pepelepoisson/geairaredit/README.md

***
This repo contains files about a project called GeaiRareDit. It is all about building a small hand-held game starting with classical SimonSays game. This is very much WIP and shall be updated as project evolves.
***
***
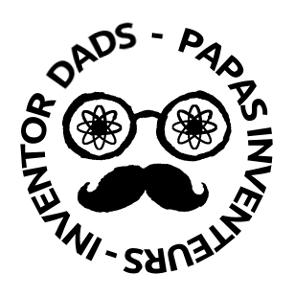
[picture p1: Logo_Papas_Inventeurs_25mm.png]
Inventor Dads logo
