pepelepoisson/geairaredit/CAD/V2 - laser cutting only/Decoupe_condensateur.png

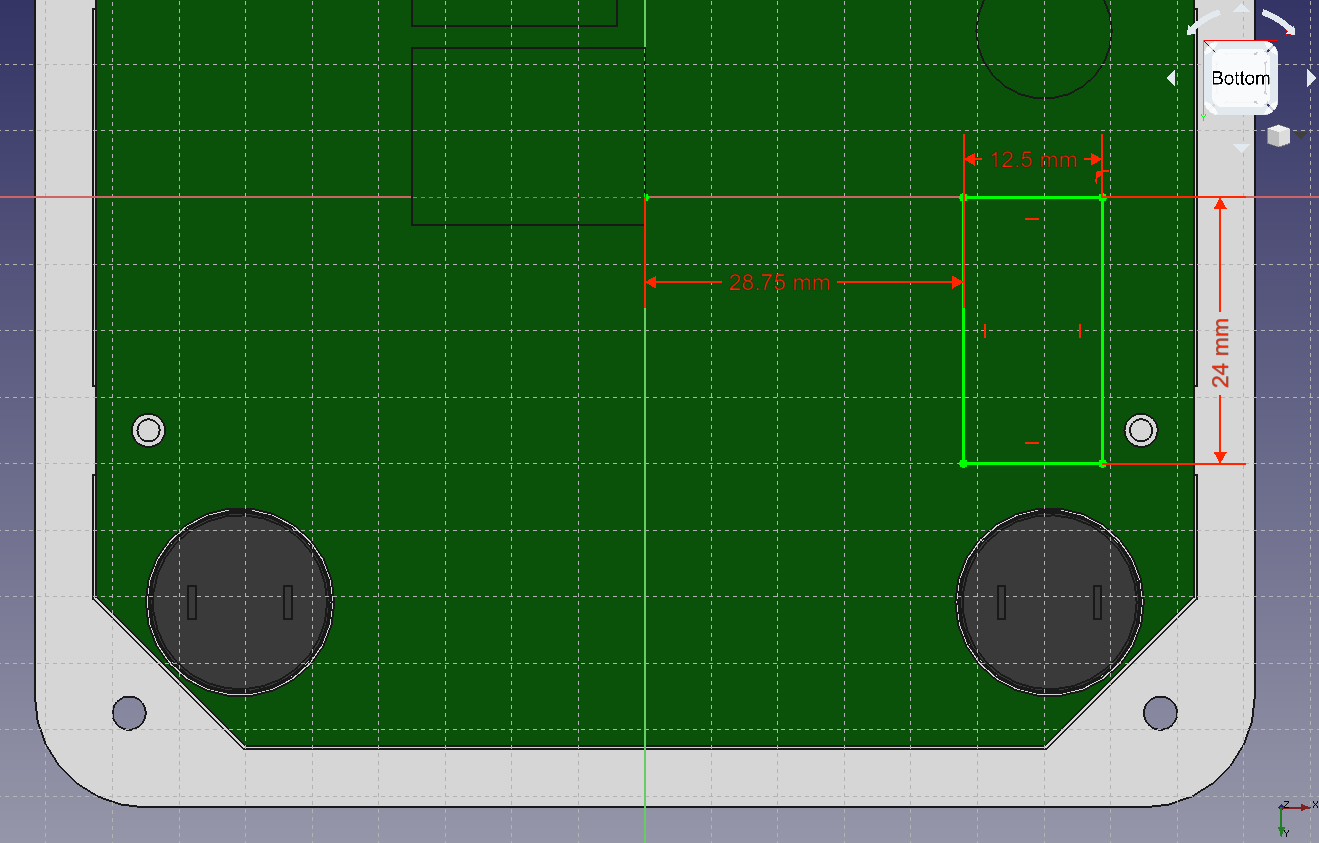
CAD/V2 - laser cutting only/Decoupe_condensateur.png
