pepelepoisson/geairaredit/CAD/V2 - laser cutting only/Dimensions_PCB.png

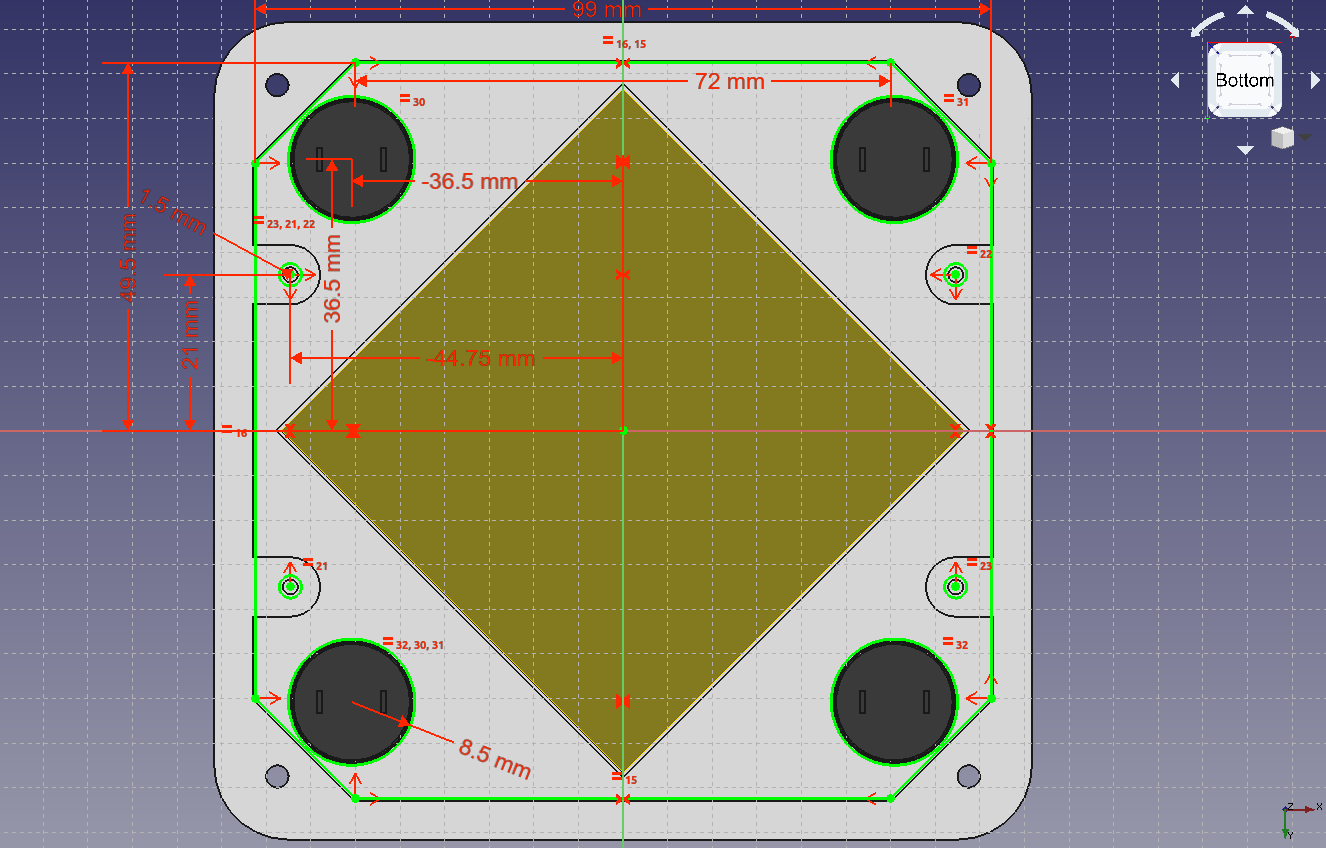
CAD/V2 - laser cutting only/Dimensions_PCB.png
