pepelepoisson/geairaredit/CAD/V2 - laser cutting only/PCB_placement.png

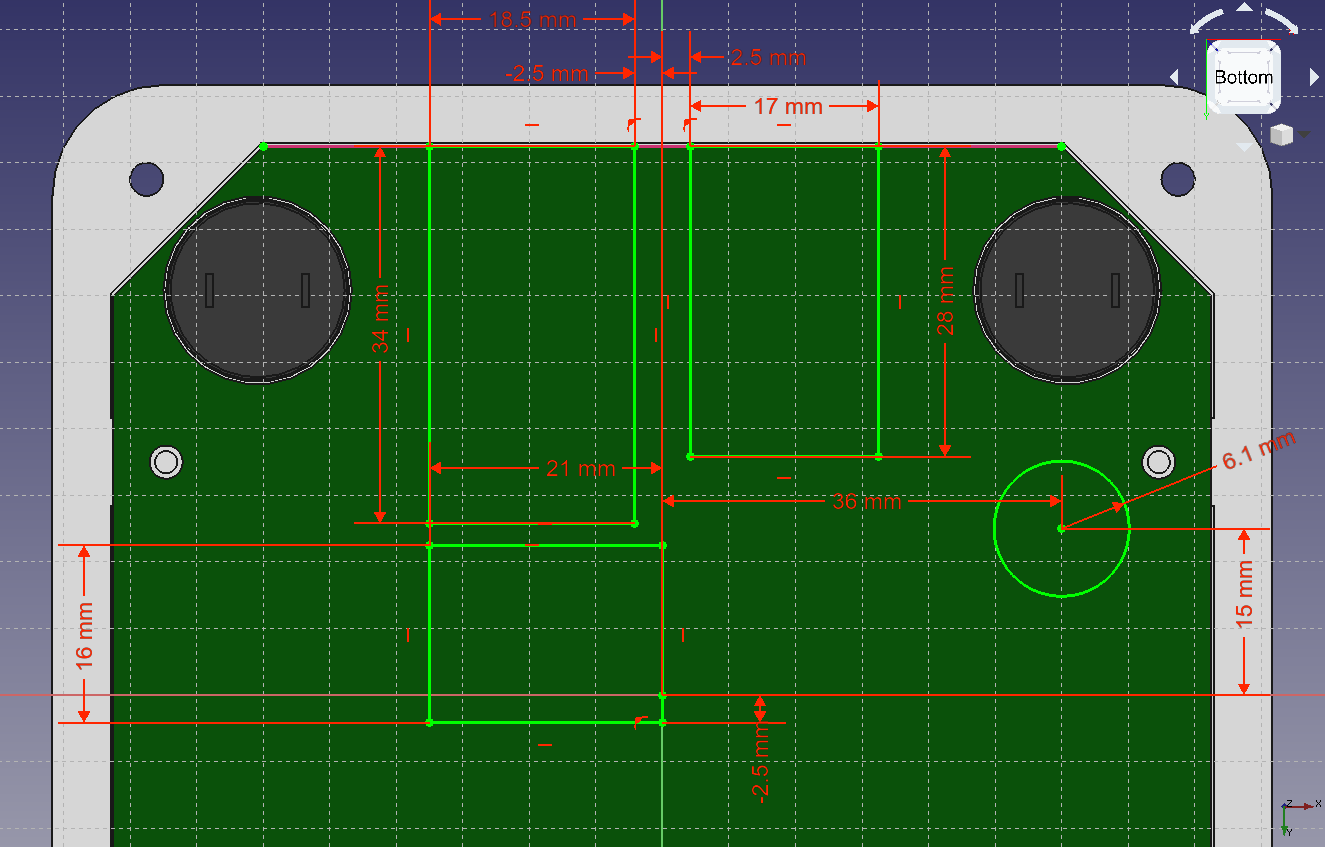
CAD/V2 - laser cutting only/PCB_placement.png
