pepelepoisson/geairaredit/CAD/V2 - laser cutting only/Rendu_arriere.png

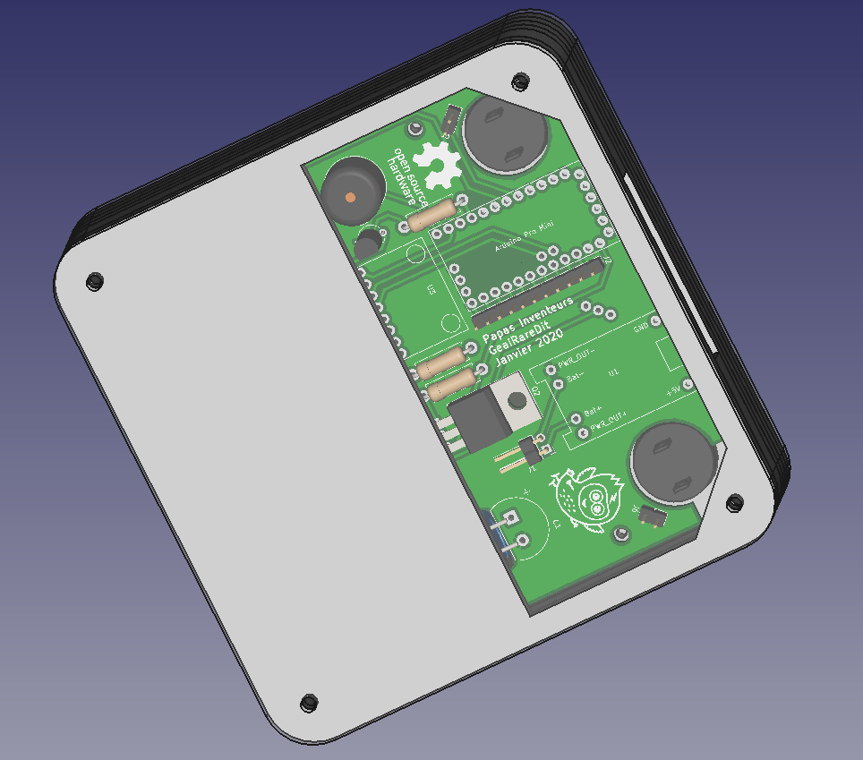
CAD/V2 - laser cutting only/Rendu_arriere.png
