pepelepoisson/geairaredit/CAD/V2 - laser cutting only/Rendu_avant.png

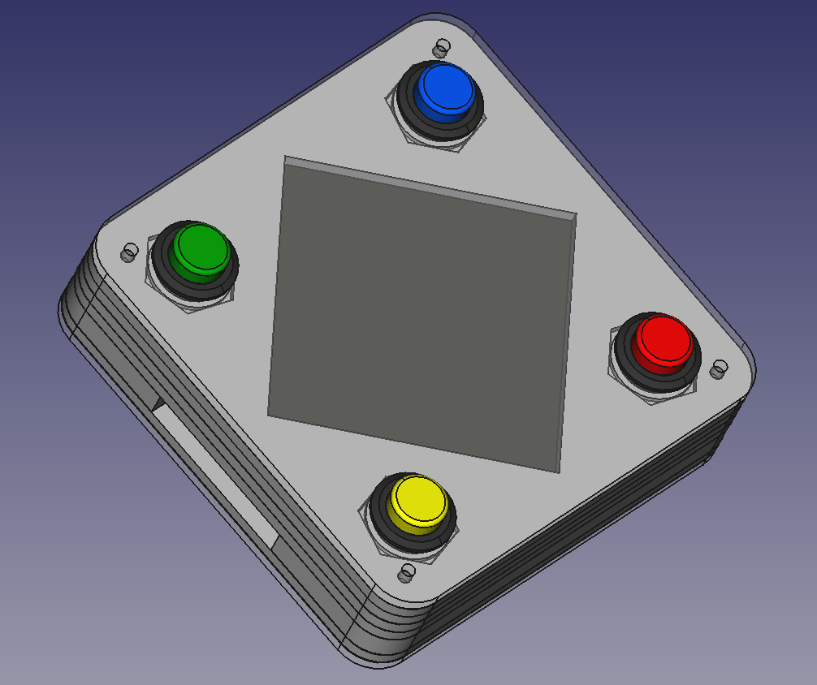
CAD/V2 - laser cutting only/Rendu_avant.png
