pepelepoisson/geairaredit/Power/Tension_decharge.png

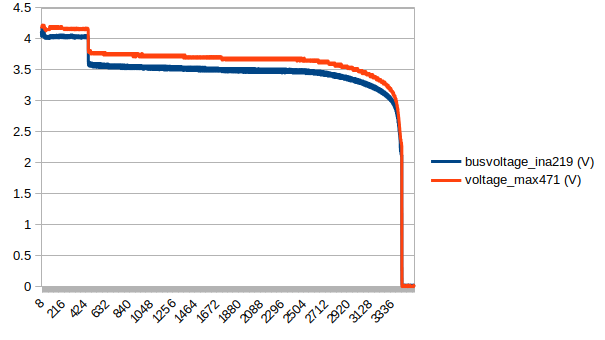
Power/Tension_decharge.png
