pepelepoisson/geairaredit/Rendu_PCB_bleu.png

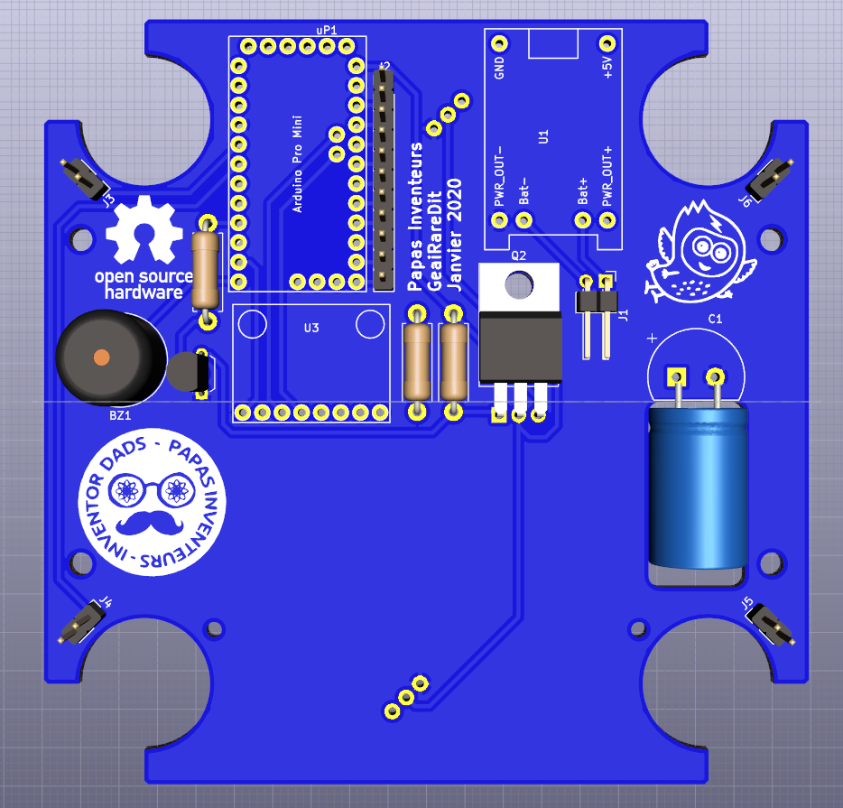
Rendu_PCB_bleu.png
