pepelepoisson/geairaredit/CAD/V1 - laser cutting and 3d printing/3D printing - back/Dessous_prototype_V3.FCStd

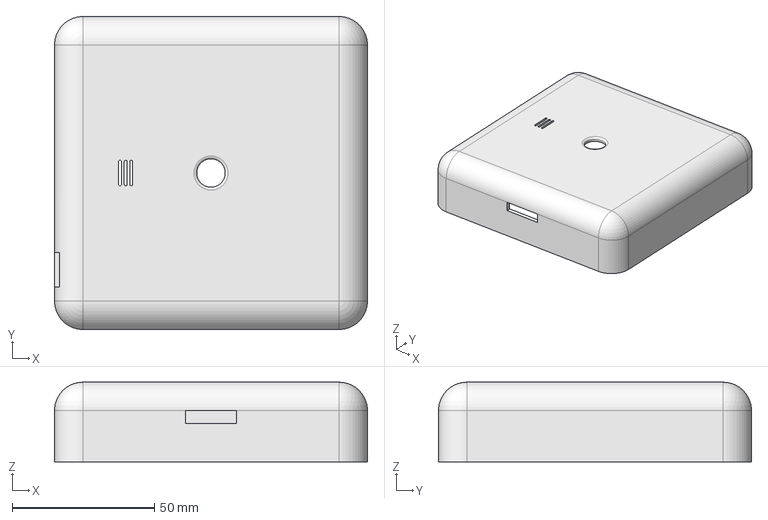
[picture p9: CAD file, 2019-12-19]
CAD/V1 - laser cutting and 3d printing/3D printing - back/Dessous_prototype_V3.FCStd
110.0 x 110.0 x 28.0 mm
