pepelepoisson/geairaredit/CAD/V1 - laser cutting and 3d printing/Laser cutting - front/Face_avant_CTP_proto_1.dxf

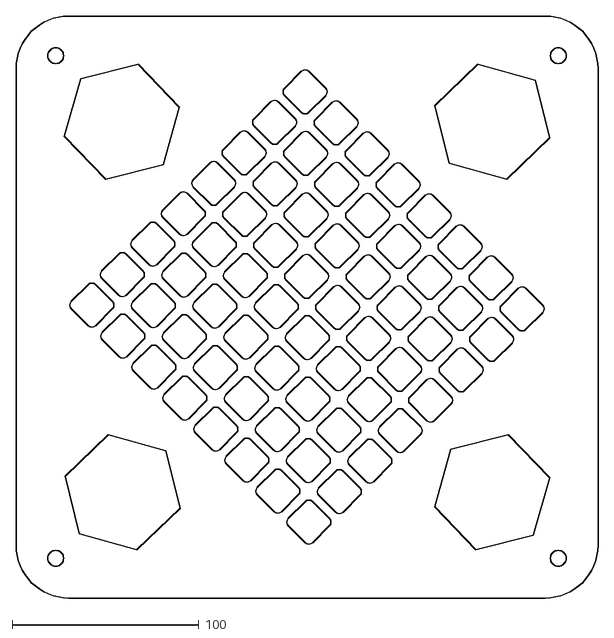
[picture p10: CAD file, 2020-12-04]
CAD/V1 - laser cutting and 3d printing/Laser cutting - front/Face_avant_CTP_proto_1.dxf
311.8 x 311.8
