pepelepoisson/geairaredit/CAD/V2 - laser cutting only/GeaiRareDit_CAD_V4.FCStd

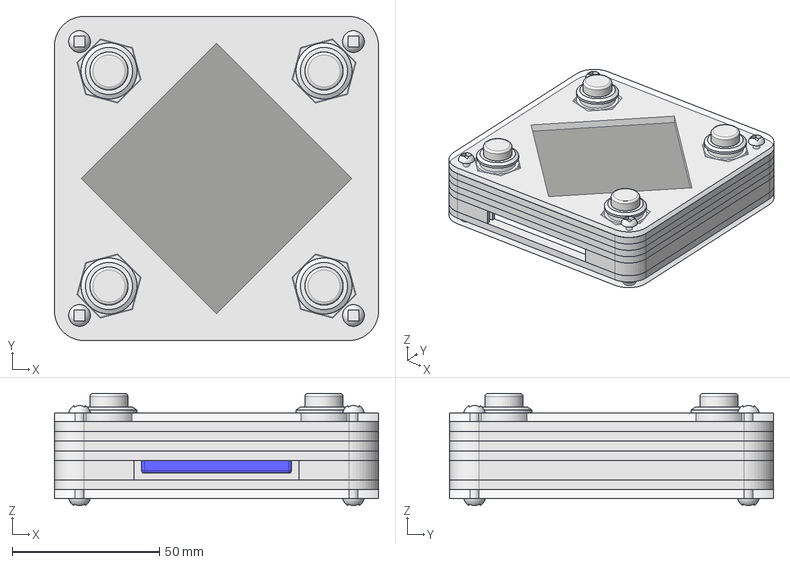
[picture p11: CAD file, 2020-01-23]
CAD/V2 - laser cutting only/GeaiRareDit_CAD_V4.FCStd
110.0 x 110.0 x 38.1 mm
Face_avant_plexi
Face_2_CTP
Matrice_LEDs
Face_3_CTP_maintien_Matrice_LEDs
Face_4_CTP_support_PCB
Face_arriere_plexi
Face_5_CTP_cote_PCB
Interrupteur vert
Interrupteur jaune
Interrupteur rouge
Batterie
Face_7_CTP
Interrupteur bleu
Face_6_CTP_cote_Acces_fils
Vis_1
Vis_2
Vis_3
Vis_4
Vis_8
Vis_7
Vis_6
Vis_5
