pepelepoisson/geairaredit/CAD/V3 - 3d printing only/Back/GeaiRareDitProto2.FCStd

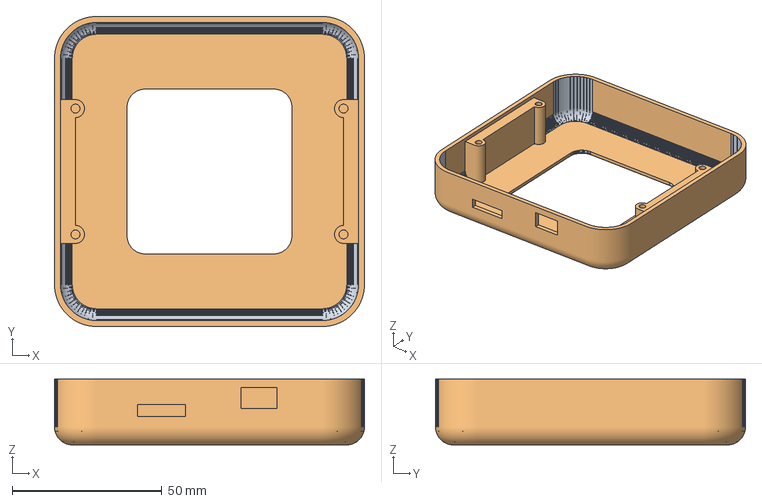
[picture p12: CAD file, 2020-12-04]
CAD/V3 - 3d printing only/Back/GeaiRareDitProto2.FCStd
103.5 x 103.5 x 22.0 mm
Body (Meshed)
