pepelepoisson/geairaredit/CAD/V3 - 3d printing only/Switch_adapter_ring/Bague_montage_boutons.FCStd

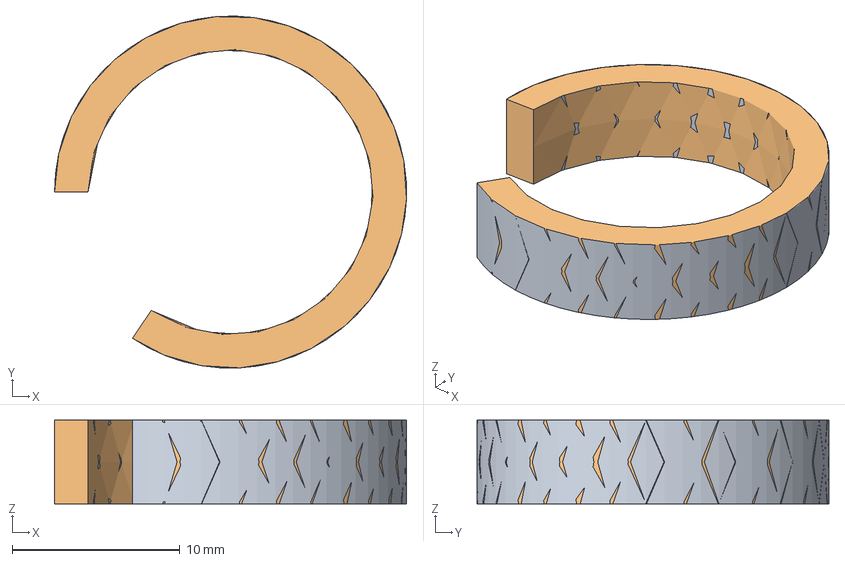
[picture p13: CAD file, 2020-12-04]
CAD/V3 - 3d printing only/Switch_adapter_ring/Bague_montage_boutons.FCStd
21.0 x 21.0 x 5.00 mm
Body (Meshed)
