pepelepoisson/geairaredit/CAD/V4 - CNC and 3d printing/GeaiRareDit_CAD_V6.FCStd

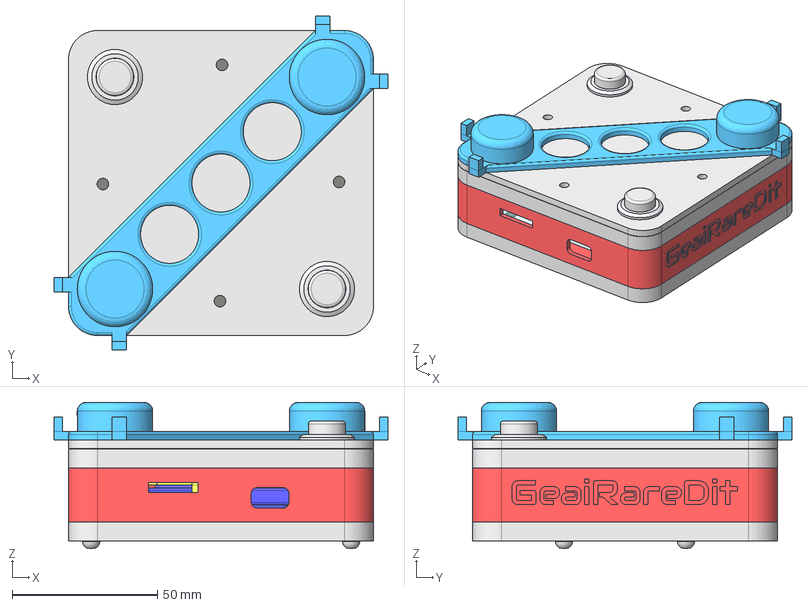
[picture p14: CAD file, 2020-12-16]
CAD/V4 - CNC and 3d printing/GeaiRareDit_CAD_V6.FCStd
115.0 x 115.0 x 50.3 mm
Face_1_CTP_3.3mm
Face_2_CTP_6.6mm
Fond_CTP
Rondelle_4_support_PCB
Rondelle_3_support_PCB
Rondelle_2_support_PCB
Rondelle_1_support_PCB
Vis_001
Vis_002
Vis_003
Vis_004
Batterie_1
Interrupteur bleu
Interrupteur rouge
Interrupteur jaune
Interrupteur vert
Matrice_LEDs
Batterie_002
Fenetre_acrylique
Contour_PLA_logo
Support_batterie_2_dessous
Support_batterie_2_dessus
Protecteur_transport
