pepelepoisson/geairaredit/CAD/V4 - CNC and 3d printing/STL files/Protecteur_transport_V1.stl

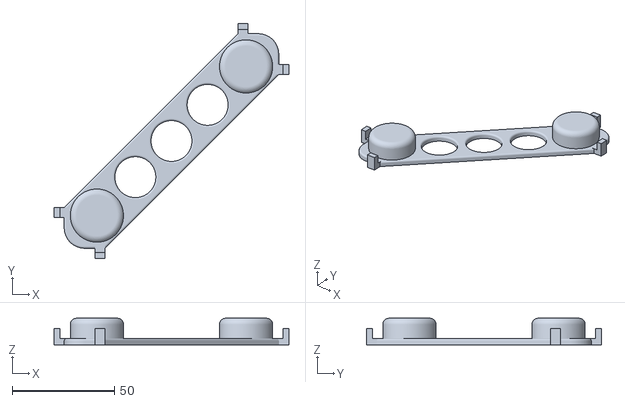
[picture p15: CAD file, 2020-12-16]
CAD/V4 - CNC and 3d printing/STL files/Protecteur_transport_V1.stl
115.0 x 115.0 x 13.0
