pepelepoisson/geairaredit/CAD/V3 - 3d printing only/Back/Boitier_Proto_GeaiRareDit_V3.stl

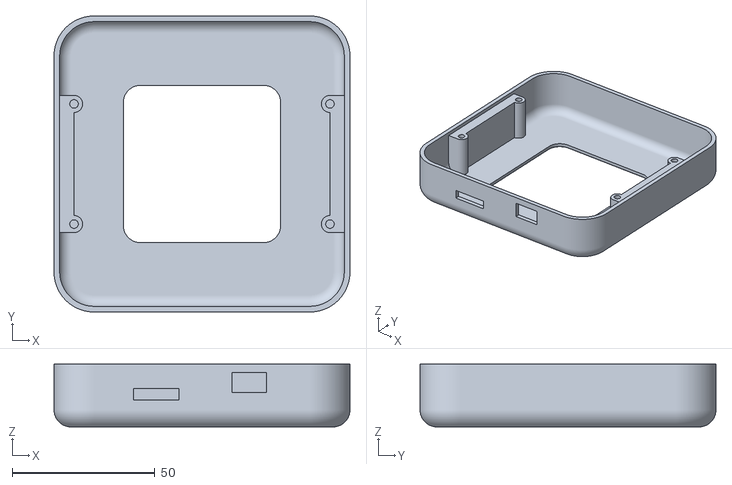
[picture p16: CAD file, 2020-12-04]
CAD/V3 - 3d printing only/Back/Boitier_Proto_GeaiRareDit_V3.stl
103.5 x 103.5 x 22.0
