pepelepoisson/geairaredit/CAD/V4 - CNC and 3d printing/STL files/Porte_batterie_dessous_V2.stl

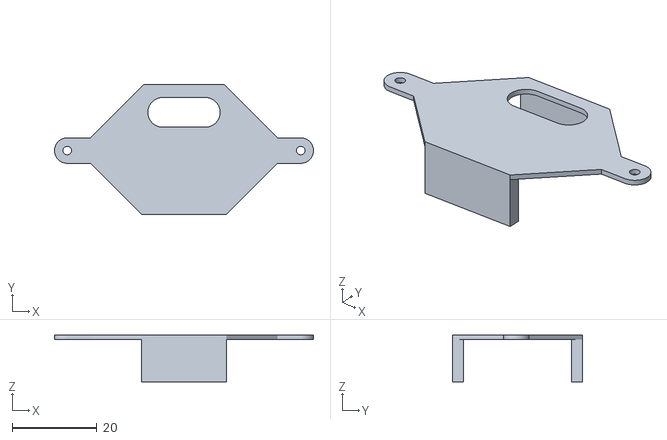
[picture p17: CAD file, 2020-12-10]
CAD/V4 - CNC and 3d printing/STL files/Porte_batterie_dessous_V2.stl
61.0 x 30.5 x 11.0
