pepelepoisson/geairaredit/CAD/V4 - CNC and 3d printing/STL files/Rondelle_support_PCB_V3.stl

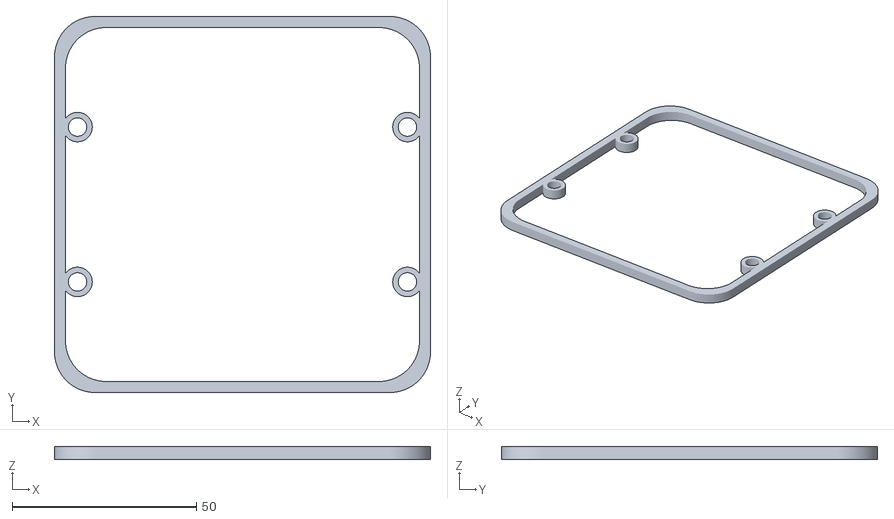
[picture p19: CAD file, 2020-12-10]
CAD/V4 - CNC and 3d printing/STL files/Rondelle_support_PCB_V3.stl
102.0 x 102.0 x 3.50
