pepelepoisson/geairaredit/CAD/V4 - CNC and 3d printing/STL files/Contour_PLA_V3.stl

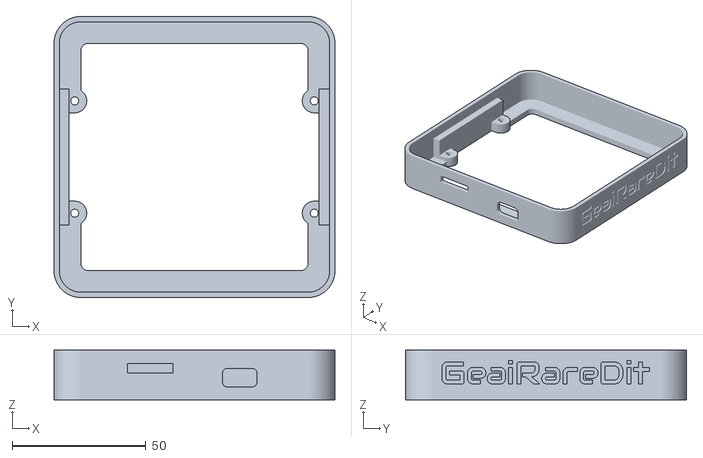
[picture p20: CAD file, 2020-12-10]
CAD/V4 - CNC and 3d printing/STL files/Contour_PLA_V3.stl
105.0 x 105.0 x 18.5
