pepelepoisson/geairaredit/CAD/V1 - laser cutting and 3d printing/3D printing - back/Old/Dessous_prototype_V2.FCStd

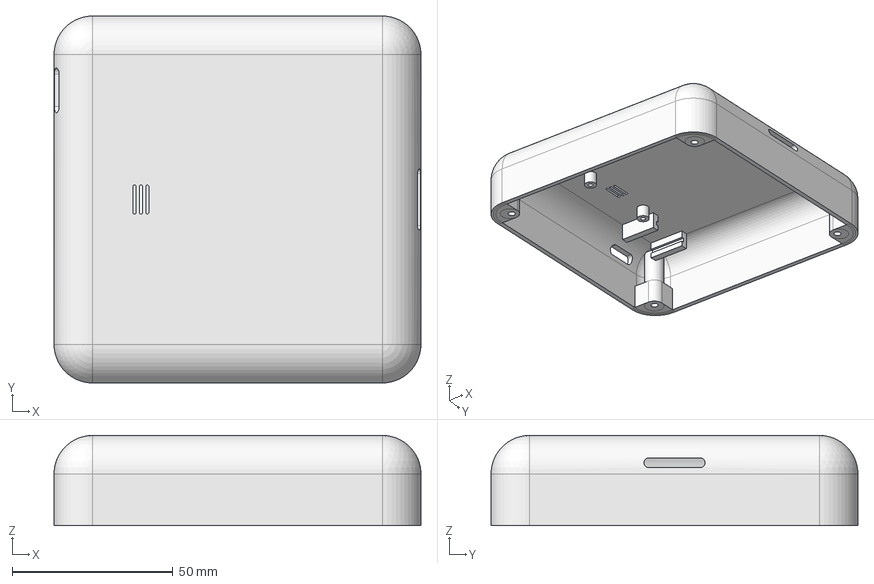
[picture p21: CAD file, 2020-12-04, an earlier design]
CAD/V1 - laser cutting and 3d printing/3D printing - back/Old/Dessous_prototype_V2.FCStd
114.0 x 114.0 x 28.0 mm
