pepelepoisson/geairaredit/CAD/V2 - laser cutting only/Old/GeaiRareDit_CAD_V3.FCStd

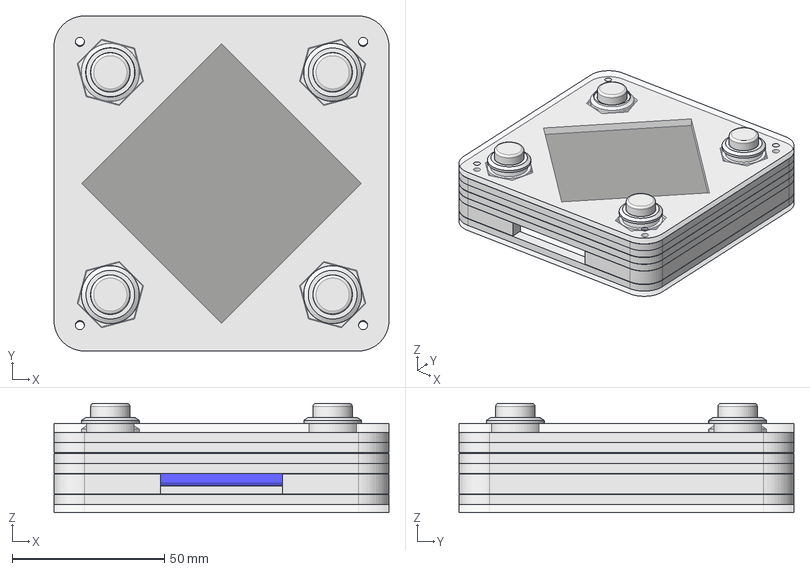
[picture p22: CAD file, 2020-12-04, an earlier design]
CAD/V2 - laser cutting only/Old/GeaiRareDit_CAD_V3.FCStd
110.0 x 110.0 x 35.9 mm
Face_avant_plexi
Face_2_CTP
Matrice_LEDs
PCB
Face_3_CTP
Face_6_CTP
Face_4_CTP
Face_arriere_plexi
Face_5_CTP
Interrupteur bleu
Interrupteur vert
Interrupteur jaune
Interrupteur rouge
Batterie
Face_7_CTP
