pepelepoisson/geairaredit/CAD/V4 - CNC and 3d printing/Old/Exploded_view.fcstd

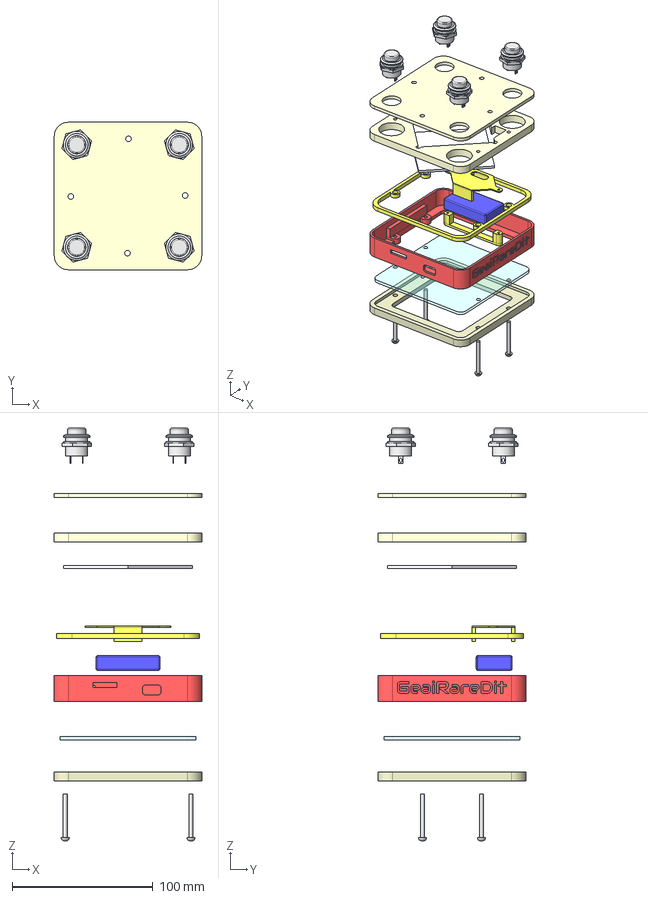
[picture p23: CAD file, 2020-12-16, an earlier design]
CAD/V4 - CNC and 3d printing/Old/Exploded_view.fcstd
105.0 x 105.0 x 293.9 mm
Face_1_CTP_3.3mm
Face_2_CTP_6.6mm
Fond_CTP
Rondelle_1_support_PCB
Vis_001
Vis_002
Vis_003
Vis_004
Interrupteur bleu
Interrupteur rouge
Interrupteur jaune
Interrupteur vert
Matrice_LEDs
Batterie_002
Fenetre_acrylique
Contour_PLA_logo
Support_batterie_2_dessous
Support_batterie_2_dessus
