pepelepoisson/geairaredit/CAD/V2 - laser cutting only/Old/GeaiRareDit_CAD_V2_bkp1.FCStd

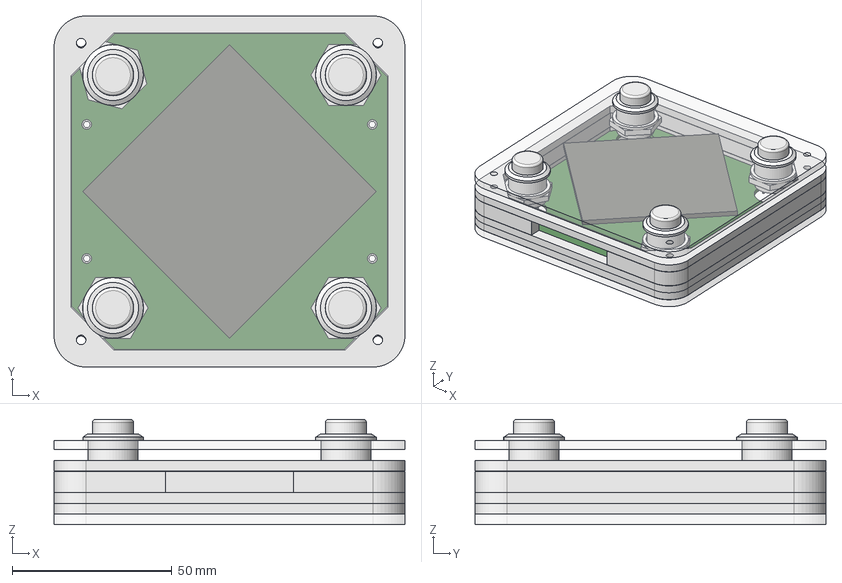
[picture p24: CAD file, 2020-12-04, an earlier design]
CAD/V2 - laser cutting only/Old/GeaiRareDit_CAD_V2_bkp1.FCStd
110.0 x 110.0 x 33.0 mm
Face_avant_plexi
Interrupteur bleu
Matrice_LEDs
PCB
Face_3_CTP
Face_4_CTP
Face_6_CTP
Face_arriere_plexi
Face_5_CTP
Interrupteur rouge
Interrupteur jaune
Interrupteur vert
