pepelepoisson/geairaredit/CAD/V4 - CNC and 3d printing/GeaiRareDit_CAD_V5.FCStd

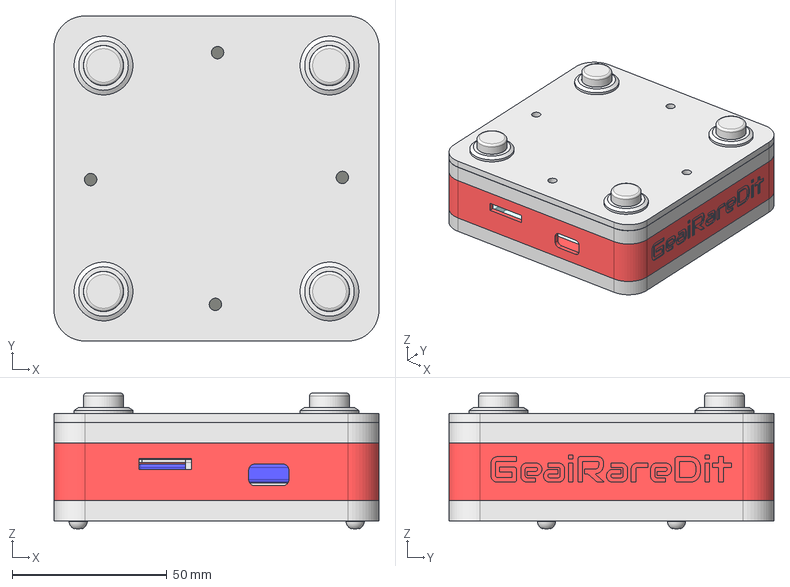
[picture p25: CAD file, 2020-12-10, an earlier design]
CAD/V4 - CNC and 3d printing/GeaiRareDit_CAD_V5.FCStd
105.0 x 105.0 x 43.9 mm
Face_1_CTP_3.3mm
Face_2_CTP_6.6mm
Support_batterie_dessous
Support_batterie_dessus
Fond_CTP
Rondelle_4_support_PCB
Rondelle_3_support_PCB
Rondelle_2_support_PCB
Rondelle_1_support_PCB
Vis_001
Vis_002
Vis_003
Vis_004
Batterie
Interrupteur bleu
Interrupteur rouge
Interrupteur jaune
Interrupteur vert
Matrice_LEDs
Fenetre_acrylique
Contour_PLA_logo
