pepelepoisson/geairaredit/(list of files, cad)

Other CAD files:
CAD/V1 - laser cutting and 3d printing/3D printing - back/Old/Dessous_prototype.FCStd
CAD/V1 - laser cutting and 3d printing/3D printing - back/Dessous_prototype_V3.stl
CAD/V1 - laser cutting and 3d printing/3D printing - back/Old/DEssous_prototype_V1.stl
CAD/V1 - laser cutting and 3d printing/3D printing - back/Old/DEssous_prototype_V2.stl
CAD/V1 - laser cutting and 3d printing/3D printing - back/Old/Dessous_prototype_V3.stl
CAD/V2 - laser cutting only/Old/GeaiRareDit_CAD_V2.FCStd
CAD/V2 - laser cutting only/Old/GeaiRareDit_CAD_V4.FCStd
CAD/V3 - 3d printing only/Switch_adapter_ring/Bague_montage_boutons.stl
CAD/V4 - CNC and 3d printing/STL files/Contour_PLA_V1.stl
CAD/V4 - CNC and 3d printing/STL files/Contour_PLA_V2.stl
CAD/V4 - CNC and 3d printing/STL files/Porte_batterie_dessous_V1.stl
CAD/V4 - CNC and 3d printing/STL files/Porte_batterie_dessus_V1.stl
CAD/V4 - CNC and 3d printing/STL files/Rondelle_support_PCB.stl
CAD/V4 - CNC and 3d printing/STL files/Rondelle_support_PCB_V2.stl
