pepelepoisson/geairaredit/CAD/V1 - laser cutting and 3d printing/3D printing - back/GeaiRareDitV2 - OK mais bavures.png

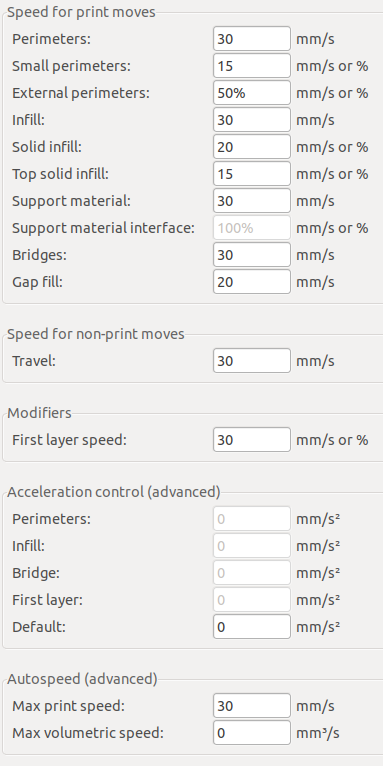
CAD/V1 - laser cutting and 3d printing/3D printing - back/GeaiRareDitV2 - OK mais bavures.png
