pepelepoisson/geairaredit/CAD/V4 - CNC and 3d printing/GeaiRareDit_exploded_view_2.png

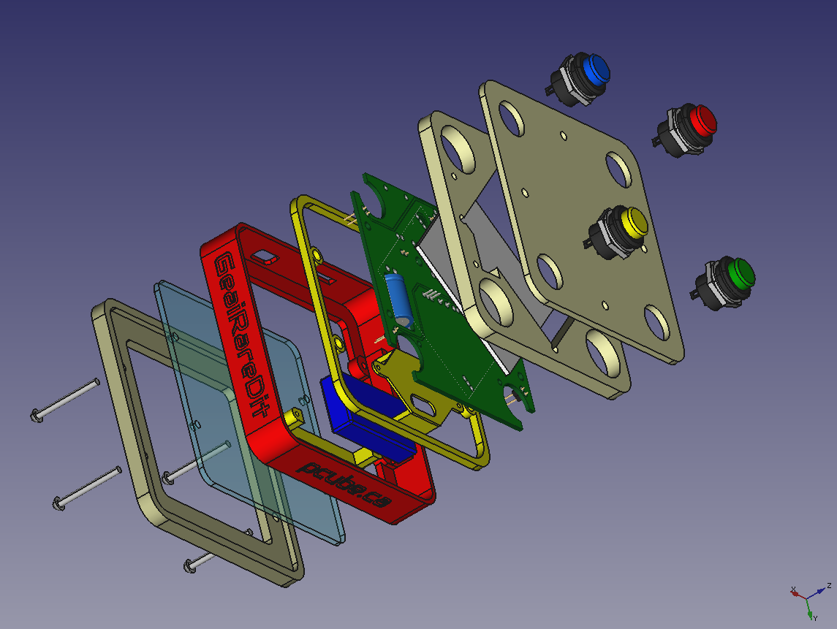
CAD/V4 - CNC and 3d printing/GeaiRareDit_exploded_view_2.png
