pepelepoisson/geairaredit/Power/ProtoV1 test power.ods

Logging to: LOGGER70.CSV
10000 | 2000/1/1 0:0:0 | 4.06 | 3.81 | 40.5 | 3.81 | 0.07 | 14.65 | 0
14999 | 2000/1/1 0:0:0 | 4.05 | 3.8 | 40.7 | 3.81 | 0.07 | 14.65 | 0
19999 | 2000/1/1 0:0:0 | 4.05 | 3.8 | 40.5 | 3.81 | 0.07 | 14.65 | 0
24998 | 2000/1/1 0:0:0 | 7.91 | 3.72 | 79.2 | 3.73 | 3.76 | 19.53 | 0.07
30000 | 2000/1/1 0:0:0 | 7.97 | 3.72 | 79.5 | 3.73 | 3.76 | 19.53 | 0.07
34999 | 2000/1/1 0:0:0 | 7.97 | 3.72 | 79.5 | 3.73 | 3.76 | 19.53 | 0.07
39999 | 2000/1/1 0:0:0 | 7.97 | 3.72 | 79.6 | 3.73 | 3.76 | 19.53 | 0.07
44999 | 2000/1/1 0:0:0 | 7.89 | 3.72 | 78.9 | 3.73 | 3.76 | 14.65 | 0.06
49998 | 2000/1/1 0:0:0 | 7.92 | 3.72 | 78.9 | 3.73 | 3.76 | 19.53 | 0.07
55000 | 2000/1/1 0:0:0 | 7.58 | 3.73 | 75.7 | 3.74 | 3.69 | 19.53 | 0.07
59999 | 2000/1/1 0:0:0 | 7.5 | 3.73 | 75 | 3.74 | 3.69 | 19.53 | 0.07
65000 | 2000/1/1 0:0:0 | 7.55 | 3.73 | 75.1 | 3.74 | 3.69 | 19.53 | 0.07
69999 | 2000/1/1 0:0:0 | 4.03 | 3.8 | 39.9 | 3.8 | 0.1 | 14.65 | 0
74999 | 2000/1/1 0:0:0 | 4.01 | 3.8 | 40.2 | 3.81 | 0.07 | 14.65 | 0
