pepelepoisson/geairaredit/Power/GeaiRareDit_power_cycles_1.pdf

## Cycles de charge et décharge de batterie GeaiRareDit

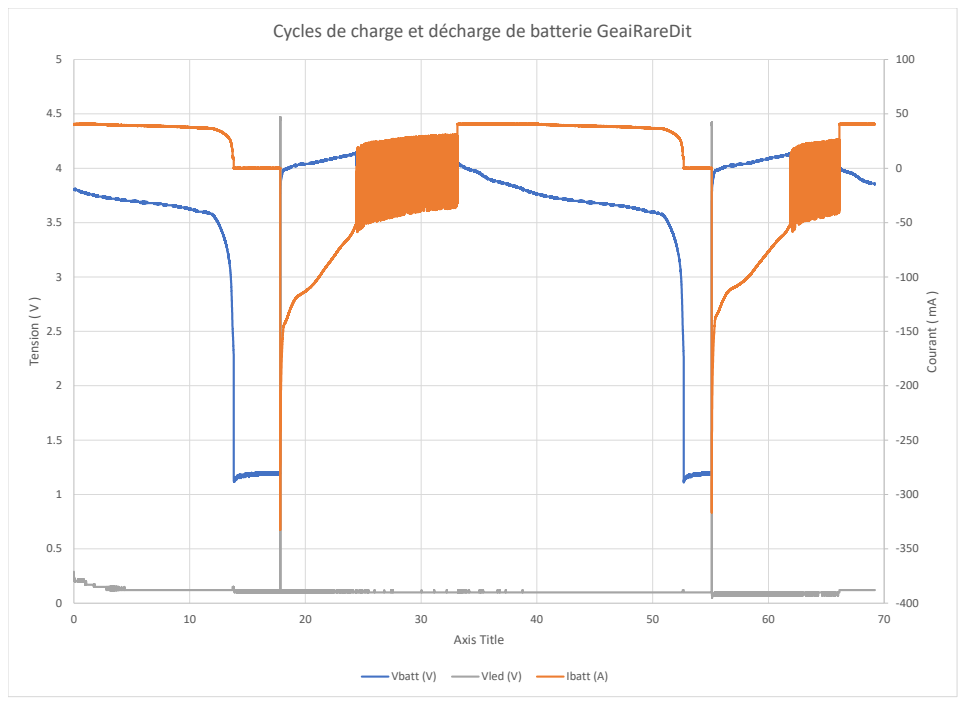
[picture p29: page 1]
Courant ( mA ); Tension ( V ); Axis Title; Vbatt (V); Vled (V); Ibatt (A)
