pepelepoisson/geairaredit/Power/GeaiRareDit_power_cycles_2.pdf

## Capacite accumulée (mAh)

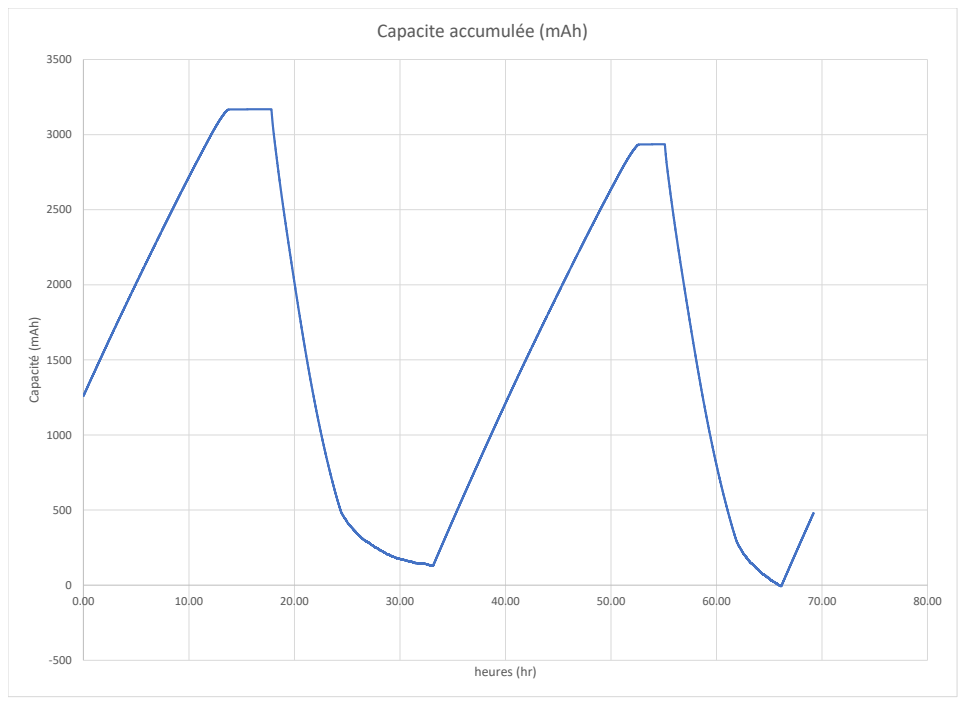
[picture p30: page 1]
Capacité (mAh); heures (hr)
