pepelepoisson/geairaredit/PCB/V1/GeaiRareDit_PCB_Kicad5.kicad_pcb

## KiCad design PCB/V1/GeaiRareDit_PCB_Kicad5.kicad_pcb (2020-01-23)

Schematic: GeaiRareDit_PCB_Kicad5.sch, GeaiRareDit

Parts:
BZ1: Buzzer; Buzzer_12x9.5RM7.6
C1: 1000microF; Edge_CP_Radial_D12.5mm_P5.00mm
J1: LIPO_IN; PinHeader_1x02_P2.54mm_Horizontal
J2: Conn_01x11; PinHeader_1x11_P2.54mm_Vertical
J3: Conn_SW1; PinHeader_1x02_P2.54mm_Vertical
J4: Conn_SW2; PinHeader_1x02_P2.54mm_Vertical
J5: Conn_SW3; PinHeader_1x02_P2.54mm_Vertical
J6: Conn_SW4; PinHeader_1x02_P2.54mm_Vertical
Q1: 2N3904; TO-92L_Inline_Wide
Q2: NPD6020P; TO-220-3_Horizontal_TabDown
R1: 10K; R_Axial_DIN0411_L9.9mm_D3.6mm_P12.70mm_Horizontal
R2: 10k; R_Axial_DIN0411_L9.9mm_D3.6mm_P12.70mm_Horizontal
R3: 470; R_Axial_DIN0411_L9.9mm_D3.6mm_P12.70mm_Horizontal
U1: LiPo_Mngmt_Board
U2: WS2812B_8x8_matrix; WS2812B_8x8_CJMCU_Matrix
U3: ITG_MPU6050; ITG_MPU_6050_big_holes
uP1: ARDUPROMINI_pins_on_4_sides; ArduinoProMini_pins_on_4_sides_big_holes

Connections:
+BATT: C1.1, Q2.3 (S), R2.2, U1.4 (PWR_OUT+), uP1.19 (RAW)
/3.3V: J2.3, uP1.22 (Vcc2)
/A0: J2.7, uP1.26 (A0)
/A1: J2.6, uP1.25 (A1)
/A2: J2.5, uP1.24 (A2)
/A3: J2.4, uP1.23 (A3)
/BUZZER: BZ1.1 (-), uP1.18 (D9)
/D2: J3.1, uP1.11 (D2)
/D3: J4.1, uP1.12 (D3)
/D4: J5.1, uP1.13 (D4)
/D5: J6.1, uP1.14 (D5)
/D10: J2.11, uP1.30 (D10)
/D11: J2.10, uP1.29 (D11)
/D12: J2.9, uP1.28 (D12)
/D13: J2.8, uP1.27 (D13)
/I2C_SCL: U3.3 (SCL), uP1.31 (A5)
/I2C_SDA: U3.4 (SDA), uP1.32 (A4)
/LIPO+: J1.1, U1.1 (Bat+)
/LIPO-: J1.2, U1.2 (Bat-)
/MOSFET_CTRL: R1.2, uP1.15 (D6)
/MPU_VCC: U3.1 (VCC), uP1.17 (D8)
/RESET: J2.2, uP1.21 (RESET)
/WS2812B_DATA_IN: R3.1, uP1.16 (D7)
GND: BZ1.2 (+), C1.2, J2.1, J3.2, J4.2, J5.2, J6.2, Q1.1 (E), U1.3 (PWR_OUT-), U2.2 (GND), U3.2 (GND), uP1.10 (GND), uP1.20 (GND3)
unnamed: Q1.2 (B), R1.1
unnamed: Q1.3 (C), Q2.1 (G), R2.1
unnamed: Q2.2 (D), U2.1 (Vin)
unnamed: R3.2, U2.3 (Din)

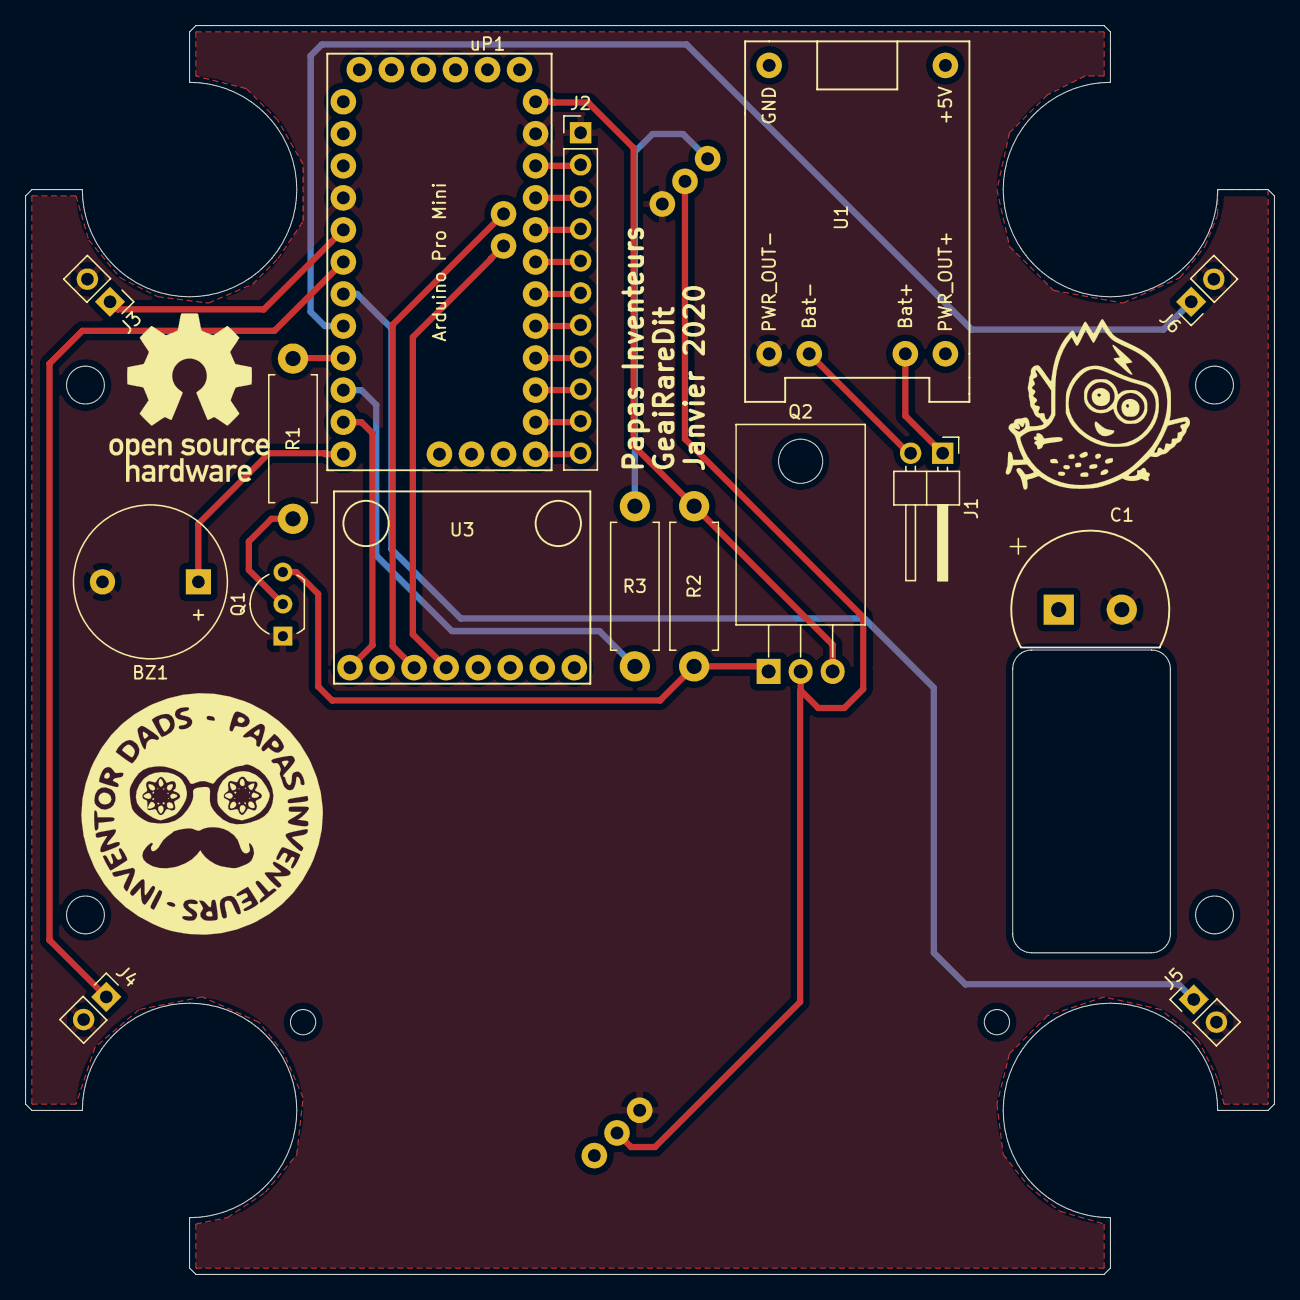
[picture p31: board GeaiRareDit_PCB_Kicad5.kicad_pcb from above]

Board: 2 copper layers, 99.0 x 99.0 mm, 17 parts (1 on the bottom side), 28 nets.
