pepelepoisson/geairaredit/Code/ArduinoIDE/GeaiRareDit_R1_0/GeaiRareDit_R1_0.ino

/*
This is Release 1.0 code that was installed on the first two units shipped to Vancouver and France

Key features:
- Gameplay almost identical to original SparkFun code with 3 modes: play against Arduino, play against other player and easter egg BeeGee music.
- Counts score and stores record permanently in EEPROM
- Manages energy with VCC check and display, sleep mode and MOSFET control to cut LED matrix power when not in use.
- Implemented basic matrix features to display text or scroll images.
- Implemented mpu core features to sense accels and orientations. Experimented with gesture control but not activated in released version because still WIP.

To do:
- Use accel to sense orientation
- Change splash screen
- Add cool lighting when goes to sleep
- Add possibility to cut sound

Done: 
- Display battery level a startup and return from sleep
- Must include an MPU calibration step at startup
- Save high score in EEPROM

Inspired from:
- Simon Says code in SparkFun Inventor's Kit Example sketch 16
- Vcc read from ???
- Sleep code from ???
  */

/*************************************************
* Libraries
*************************************************/
#include <Arduino.h>
#include <Adafruit_GFX.h>            // version=1.2.2 Author=Adafruit
#include <Adafruit_NeoMatrix.h>      // version=1.1.2 Author=Adafruit
#include <Adafruit_NeoPixel.h>       // version=1.1.2 Author=Adafruit
#include "monochrome_5x3_symbols.h"  // Monochrome bitmaps for 5x3 numbers and symbols
#include "monochrome_8x8_symbols.h"  // Monochrome bitmaps for 8x8 symbols
#include "small_font_5x3-4pts.h"     // Definition of alternate 5x3-4pts font
#include <I2Cdev.h>
#include <MPU6050.h>
#include "Wire.h"
#include <RunningMedian.h>
#include <avr/interrupt.h> // Librairies for sleep mode
#include <avr/power.h> // Librairies for sleep mode
#include <avr/sleep.h> // Librairies for sleep mode
#include <avr/io.h> // Librairies for sleep mode
#include <EEPROM.h>  // To store data to EEPROM library

/*************************************************
* Public Constants
*************************************************/
// USER-DEFINED CONFIG SETTINGS AND TUNABLES
#define BRIGHTNESS 5                 // 0-255 LEDs brightness - default setting
#define SHOW_SPLASH_SCREEN 0          // Set to 1 to show splash screen at startup, 0 otherwise
#define USE_5X3_FONT 1                // Set to 1 to use small 5pts font instead of standard 7pts
#define MAX_REST_TIME 60000           //max waiting time before going to sleep
#define MAX_IDLE_TIME 60000           //max waiting time with animation before going to rest
#define TILT_LIMIT 20

// Notes used for sounds and tones
#define NOTE_B0 31
#define NOTE_C1 33
#define NOTE_CS1 35
#define NOTE_D1 37
#define NOTE_DS1 39
#define NOTE_E1 41
#define NOTE_F1 44
#define NOTE_FS1 46
#define NOTE_G1 49
#define NOTE_GS1 52
#define NOTE_A1 55
#define NOTE_AS1 58
#define NOTE_B1 62
#define NOTE_C2 65
#define NOTE_CS2 69
#define NOTE_D2 73
#define NOTE_DS2 78
#define NOTE_E2 82
#define NOTE_F2 87
#define NOTE_FS2 93
#define NOTE_G2 98
#define NOTE_GS2 104
#define NOTE_A2 110
#define NOTE_AS2 117
#define NOTE_B2 123
#define NOTE_C3 131
#define NOTE_CS3 139
#define NOTE_D3 147
#define NOTE_DS3 156
#define NOTE_E3 165
#define NOTE_F3 175
#define NOTE_FS3 185
#define NOTE_G3 196
#define NOTE_GS3 208
#define NOTE_A3 220
#define NOTE_AS3 233
#define NOTE_B3 247
#define NOTE_C4 262
#define NOTE_CS4 277
#define NOTE_D4 294
#define NOTE_DS4 311
#define NOTE_E4 330
#define NOTE_F4 349
#define NOTE_FS4 370
#define NOTE_G4 392
#define NOTE_GS4 415
#define NOTE_A4 440
#define NOTE_AS4 466
#define NOTE_B4 494
#define NOTE_C5 523
#define NOTE_CS5 554
#define NOTE_D5 587
#define NOTE_DS5 622
#define NOTE_E5 659
#define NOTE_F5 698
#define NOTE_FS5 740
#define NOTE_G5 784
#define NOTE_GS5 831
#define NOTE_A5 880
#define NOTE_AS5 932
#define NOTE_B5 988
#define NOTE_C6 1047
#define NOTE_CS6 1109
#define NOTE_D6 1175
#define NOTE_DS6 1245
#define NOTE_E6 1319
#define NOTE_F6 1397
#define NOTE_FS6 1480
#define NOTE_G6 1568
#define NOTE_GS6 1661
#define NOTE_A6 1760
#define NOTE_AS6 1865
#define NOTE_B6 1976
#define NOTE_C7 2093
#define NOTE_CS7 2217
#define NOTE_D7 2349
#define NOTE_DS7 2489
#define NOTE_E7 2637
#define NOTE_F7 2794
#define NOTE_FS7 2960
#define NOTE_G7 3136
#define NOTE_GS7 3322
#define NOTE_A7 3520
#define NOTE_AS7 3729
#define NOTE_B7 3951
#define NOTE_C8 4186
#define NOTE_CS8 4435
#define NOTE_D8 4699
#define NOTE_DS8 4978

#define CHOICE_OFF      0 //Used to control LEDs
#define CHOICE_NONE     0 //Used to check buttons
#define CHOICE_RED  (1 << 0)
#define CHOICE_GREEN    (1 << 1)
#define CHOICE_BLUE (1 << 2)
#define CHOICE_ORANGE   (1 << 3)

// Hardware pins
#define LEDS_PIN 7        // Pin connected to WS2812B data in
#define BUILT_IN_LED 13
#define MOSFET_PIN 6      // Pin connected to MOSFET - Must be active to supply power to LEDs
#define BUTTON_RED    2   // Is also used to wake-up board from sleep mode
#define BUTTON_GREEN  3
#define BUTTON_BLUE   5
#define BUTTON_ORANGE 4
#define MPU_VCC  8  // VCC supply to MPU accelerometer
#define BUZZER1  9  // Buzzer pin definitions (the other pin goes to ground)

// Define game parameters
#define ROUNDS_TO_WIN      31 //Number of rounds to succesfully remember before you win. 13 is do-able.
#define ENTRY_TIME_LIMIT   3000 //Amount of time to press a button before game times out. 3000ms = 3 sec
#define MODE_MEMORY  0
#define MODE_BATTLE  1
#define MODE_BEEGEES 2

#define BIT(n,i) (n>>i&1)  // Function used to read bit i of variable n

// Game state variables
byte gameMode = MODE_MEMORY; //By default, let's play the memory game
byte gameBoard[32]; //Contains the combination of buttons as we advance
byte gameRound = 0; //Counts the number of succesful rounds the player has made it through
byte gameRecord = 0; //Counts highest score achieved

// LED MATRIX VARIABLES DECLARATION OR DEFINITION
#define mw 8    // Define matrix width
#define mh 8    // Define matrix height

// Mapping of matrix rotation setting to be used depending on orientation. Index @ position = orientation. Value @ position = set rotation setting (0, 1,2 0r 3). Default = 2 for Lumivelo2019
int8_t matrix_set_rotation[7]={ 2, 2, 1, 0, 3, 2, 2 };

Adafruit_NeoMatrix *matrix = new Adafruit_NeoMatrix(mw, mh, LEDS_PIN,
  NEO_MATRIX_TOP     + NEO_MATRIX_RIGHT +
  NEO_MATRIX_COLUMNS + NEO_MATRIX_PROGRESSIVE,
  NEO_GRB            + NEO_KHZ800);  // MATRIX DECLARATION:

// Color definitions
// This could also be defined as matrix->color(255,0,0) but those defines
// are meant to work for adafruit_gfx backends that are lacking color()
#define LED_BLACK    0

#define LED_RED_VERYLOW   (3 <<  11)
#define LED_RED_LOW     (7 <<  11)
#define LED_RED_MEDIUM    (15 << 11)
#define LED_RED_HIGH    (31 << 11)

#define LED_GREEN_VERYLOW (1 <<  5)
#define LED_GREEN_LOW     (15 << 5)
#define LED_GREEN_MEDIUM  (31 << 5)
#define LED_GREEN_HIGH    (63 << 5)

#define LED_BLUE_VERYLOW  3
#define LED_BLUE_LOW    7
#define LED_BLUE_MEDIUM   15
#define LED_BLUE_HIGH     31

#define LED_ORANGE_VERYLOW  (LED_RED_VERYLOW + LED_GREEN_VERYLOW)
#define LED_ORANGE_LOW    (LED_RED_LOW     + LED_GREEN_LOW)
#define LED_ORANGE_MEDIUM (LED_RED_MEDIUM  + LED_GREEN_MEDIUM)
#define LED_ORANGE_HIGH   (LED_RED_HIGH    + LED_GREEN_HIGH)

#define LED_PURPLE_VERYLOW  (LED_RED_VERYLOW + LED_BLUE_VERYLOW)
#define LED_PURPLE_LOW    (LED_RED_LOW     + LED_BLUE_LOW)
#define LED_PURPLE_MEDIUM (LED_RED_MEDIUM  + LED_BLUE_MEDIUM)
#define LED_PURPLE_HIGH   (LED_RED_HIGH    + LED_BLUE_HIGH)

#define LED_CYAN_VERYLOW  (LED_GREEN_VERYLOW + LED_BLUE_VERYLOW)
#define LED_CYAN_LOW    (LED_GREEN_LOW     + LED_BLUE_LOW)
#define LED_CYAN_MEDIUM   (LED_GREEN_MEDIUM  + LED_BLUE_MEDIUM)
#define LED_CYAN_HIGH   (LED_GREEN_HIGH    + LED_BLUE_HIGH)

#define LED_WHITE_VERYLOW (LED_RED_VERYLOW + LED_GREEN_VERYLOW + LED_BLUE_VERYLOW)
#define LED_WHITE_LOW   (LED_RED_LOW     + LED_GREEN_LOW     + LED_BLUE_LOW)
#define LED_WHITE_MEDIUM  (LED_RED_MEDIUM  + LED_GREEN_MEDIUM  + LED_BLUE_MEDIUM)
#define LED_WHITE_HIGH    (LED_RED_HIGH    + LED_GREEN_HIGH    + LED_BLUE_HIGH)

// Variables used in CheckAccel() routine
MPU6050 accelgyro;
int16_t ax, ay, az;
int16_t gx, gy, gz;
String accel_status=String("unknown");
RunningMedian a1RollingSample = RunningMedian(5);
RunningMedian a2RollingSample = RunningMedian(5);
RunningMedian a3RollingSample = RunningMedian(5);
int a1_offset=0,a2_offset=0,a3_offset=0;  // Offset established during calibration routine and added after to all accelerations to correct for sensor misalignment
enum POSITION { NONE, POSITION_1,POSITION_2,POSITION_3,POSITION_4, POSITION_5, POSITION_6, RED_DOWN, BLUE_DOWN, YELLOW_DOWN, GREEN_DOWN, RED_RELEASED, BLUE_RELEASED, YELLOW_RELEASED, GREEN_RELEASED, COUNT };  // Used to detect orientation of the game relative to gravity
const char *position[COUNT] = { "None", "POSITION_1", "POSITION_2", "POSITION_3", "POSITION_4", "POSITION_5", "POSITION_6","RED_DOWN", "BLUE_DOWN", "YELLOW_DOWN", "GREEN_DOWN", "RED_RELEASED", "BLUE_RELEASED", "YELLOW_RELEASED", "GREEN_RELEASED" };
uint8_t orientation = NONE, previous_orientation=NONE;
int debug_orientation=0;

//Definition of various other variables
int16_t bmpcolor[] = { LED_GREEN_HIGH, LED_BLUE_HIGH, LED_RED_HIGH };
int16_t morebmpcolor[] = { LED_RED_VERYLOW,LED_RED_LOW,LED_RED_MEDIUM,LED_RED_HIGH,LED_GREEN_VERYLOW,LED_GREEN_LOW,LED_GREEN_MEDIUM,LED_GREEN_HIGH,
                            LED_BLUE_VERYLOW,LED_BLUE_LOW,LED_BLUE_MEDIUM,LED_BLUE_HIGH,LED_ORANGE_VERYLOW,LED_ORANGE_LOW,LED_ORANGE_MEDIUM,LED_ORANGE_HIGH,
                            LED_PURPLE_VERYLOW,LED_PURPLE_LOW,LED_PURPLE_MEDIUM,LED_PURPLE_HIGH,LED_CYAN_VERYLOW,LED_CYAN_LOW,LED_CYAN_MEDIUM,LED_CYAN_HIGH,
                            LED_WHITE_VERYLOW,LED_WHITE_LOW,LED_WHITE_MEDIUM,LED_WHITE_HIGH};
uint8_t y_text_ref= 0;  // Reference position used when displaying text on the matrix
int Vcc=0;  // Variable holding battery voltage in mV
unsigned long ref_time=0, start_time=0, current_time=0, elapsed_time=0;  // Time references and counters
uint16_t menucolor[] = { LED_RED_MEDIUM, LED_BLUE_MEDIUM,  LED_ORANGE_MEDIUM, LED_GREEN_MEDIUM};  // Sequence of colors in menu cycles
uint16_t menusymbol[] = { 7,8,9,10 };  // Sequence of symbols from monochrome_8x8_symbols.h in menu cycles
uint8_t i=0;  // general purpose index
uint16_t current_color = 0;
/*********************************s****************
* Subroutines
*************************************************/

void CalibrateAccel(){
  // Reads acceleration from MPU6050 at startup to set offsets.
  // Tunables:
  // Output values: a1_offset, a2_offset, a3_offset


  int a1 = 0;
  int a2 = 0;
  int a3 = 0;
  int num_iter=100;
  
  for (int i=0; i<num_iter; i++) {
    // Get accelerometer readings
    accelgyro.getMotion6(&ax, &ay, &az, &gx, &gy, &gz);
    
  //Serial.print(ax/164);  Serial.print(",");Serial.print(ay/164);  Serial.print(",");Serial.println(az/164);
  
  // Convert to "cents of g" for MPU range set to 2g then add to sum
  a1 = a1+ax/164;
  a2 = a2+ay/164;
  a3 = a3+az/164;
  }

  // Calculate average value and set as offset - A +100 correction is added to the vertical axis so that the offset is normally close to zero 
  a1_offset=a1/num_iter;
  a2_offset=a2/num_iter;
  a3_offset=a3/num_iter+100;

  //Serial.print("Offsets:"); Serial.print(a1_offset); Serial.print(",");Serial.print(a2_offset);  Serial.print(",");Serial.println(a3_offset);

 }

void CheckAccel(){
  // Reads acceleration from MPU6050 to evaluate current condition.
  // Tunables:
  // Output values: accel_status=fallen or straight
  //                orientation=POSITION_1 to POSITION_6
  
  // Get accelerometer readings
  accelgyro.getMotion6(&ax, &ay, &az, &gx, &gy, &gz);

  /*
  Serial.print("ax/164=");Serial.print(ax/164);
  Serial.print(" ay/164=");Serial.print(ay/164);
  Serial.print(" az/164=");Serial.println(az/164);

  Serial.print(ax/164);
  Serial.print(",");Serial.print(ay/164);
  Serial.print(",");Serial.println(az/164);

  */

  // Convert to "cents of g" for MPU range set to 2g
  int a1 = ax/164;
  int a2 = ay/164;
  //int a2 = 60+ay/164;
  int a3 = az/164;

  // Update rolling average for smoothing
  a1RollingSample.add(a1);
  a2RollingSample.add(a2);
  a3RollingSample.add(a3);

  // Get median
  int a1RollingSampleMedian=a1RollingSample.getMedian()-a1_offset;
  int a2RollingSampleMedian=a2RollingSample.getMedian()-a2_offset;
  int a3RollingSampleMedian=a3RollingSample.getMedian()-a3_offset;

  
  // Evaluate current condition based on smoothed accelarations
  //accel_status="unknown";
  //if (abs(a2RollingSampleMedian)>abs(a3RollingSampleMedian)||abs(a1RollingSampleMedian)>abs(a3RollingSampleMedian)){accel_status="fallen";}
  //if (abs(a2RollingSampleMedian)<abs(a3RollingSampleMedian)&&abs(a1RollingSampleMedian)<abs(a3RollingSampleMedian)){accel_status="straight";}
  //else {accel_status="unknown";}




  if (a1RollingSampleMedian <= -TILT_LIMIT && (a2RollingSampleMedian) <= -TILT_LIMIT && (a3RollingSampleMedian) <= -80 && orientation != RED_DOWN) {
  // Red = down
  orientation = RED_DOWN;
  debug_orientation=1;
  }
  else if (a1RollingSampleMedian <= -TILT_LIMIT && (a2RollingSampleMedian) >= TILT_LIMIT && (a3RollingSampleMedian) <= -80 && orientation != BLUE_DOWN) {
  // Red = down
  orientation = BLUE_DOWN;
  debug_orientation=2;
  }
  else if (a1RollingSampleMedian >= TILT_LIMIT && (a2RollingSampleMedian) >= TILT_LIMIT && (a3RollingSampleMedian) <= -80 && orientation != YELLOW_DOWN) {
  // Red = down
  orientation = YELLOW_DOWN;
  debug_orientation=3;
  }
  else if (a1RollingSampleMedian >= TILT_LIMIT && (a2RollingSampleMedian) <= -TILT_LIMIT && (a3RollingSampleMedian) <= -80 && orientation != GREEN_DOWN) {
  // Red = down
  orientation = GREEN_DOWN;
  debug_orientation=4;
  }
  /*else if (a3RollingSampleMedian <= -75 && abs(a1RollingSampleMedian) <= 15 && abs(a2RollingSampleMedian) <= 15 && orientation == RED_DOWN) {
  // Red = down
  orientation = RED_RELEASED;
  debug_orientation=-1;
  delay (500);
  }
  else if (a3RollingSampleMedian <= -75 && abs(a1RollingSampleMedian) <= 15 && abs(a2RollingSampleMedian) <= 15 && orientation == BLUE_DOWN) {
  // Red = down
  orientation = BLUE_RELEASED;
  debug_orientation=-2;
  delay (500);
  }
  else if (a3RollingSampleMedian <= -75 && abs(a1RollingSampleMedian) <= 15 && abs(a2RollingSampleMedian) <= 15 && orientation == YELLOW_DOWN) {
  // Red = down
  orientation = YELLOW_RELEASED;
  delay (500);
  debug_orientation=-3;
  }
  else if (a3RollingSampleMedian <= -75 && abs(a1RollingSampleMedian) <= 15 && abs(a2RollingSampleMedian) <= 15 && orientation == GREEN_DOWN) {
  // Red = down
  orientation = GREEN_RELEASED;
  delay (500);
  debug_orientation=-4;
  }
  */
  else if (a1RollingSampleMedian >= 80 && abs(a3RollingSampleMedian) <= 25 && abs(a2RollingSampleMedian) <= 25 && orientation != POSITION_1) {
    // Red = top right
    orientation = POSITION_1;}
  else if (a2RollingSampleMedian >= 80 && abs(a3RollingSampleMedian) <= 25 && abs(a1RollingSampleMedian) <= 25 && orientation != POSITION_2) {
    // Red = top left
    orientation = POSITION_2;}
  else if (a1RollingSampleMedian <= -80 && abs(a3RollingSampleMedian) <= 25 && abs(a2RollingSampleMedian) <= 25 && orientation != POSITION_3) {
    // Red = bottom left
    orientation = POSITION_3;}
  else if (a2RollingSampleMedian <= -80 && abs(a3RollingSampleMedian) <= 25 && abs(a1RollingSampleMedian) <= 25 && orientation != POSITION_4) {
    // Red = bottom right
    orientation = POSITION_4;}
  else if (a3RollingSampleMedian <= -80 && abs(a1RollingSampleMedian) <= 25 && abs(a2RollingSampleMedian) <= 25 && orientation != POSITION_5) {
    // Red = up
    orientation = POSITION_5;debug_orientation=0;}
  else if (a3RollingSampleMedian >= 80 && abs(a1RollingSampleMedian) <= 25 && abs(a2RollingSampleMedian) <= 25 && orientation != POSITION_6) {
    // Red = down
    orientation = POSITION_6;
  }
  else {
    // orientation = FACE_NONE;
  }
 //Serial.print("orientation="); Serial.println(position[orientation]);
/*
  Serial.print(a1RollingSampleMedian);
  Serial.print(",");Serial.print(a2RollingSampleMedian);
  Serial.print(",");Serial.print(a3RollingSampleMedian);
  Serial.print(",");Serial.println(debug_orientation*20);  
 */

  /*
  // for debugging
  Serial.print("a1:");
  Serial.print(a1RollingSampleMedian);
  Serial.print(" a2:");// Is also used to wake-up board from sleep mode
  Serial.print(a2RollingSampleMedian);
  Serial.print(" a3:");
  Serial.print(a3RollingSampleMedian);
  Serial.print(" - ");
  Serial.print(position_stecchino[orientation]);
  Serial.print(" - ");
  Serial.print(accel_status);
  */

 }

void display_bitmap(uint8_t bmp_num, uint16_t color){   // Displays 8x8 monochrome images from mono_bmp table
    matrix->fillRect(0,0, 8,8, LED_BLACK);  // Clear the space under the bitmap that will be drawn
    matrix->drawBitmap(0, 0, mono_bmp[bmp_num], 8, 8, color);
    matrix->show();
}

void display_5x3_font(uint8_t bmp_num, uint16_t color,uint8_t xref, uint8_t yref){   // Displays 5x3 monochrome images or symbols from small_font table
    matrix->fillRect(xref, yref, xref+3,yref+5, LED_BLACK);  // Clear the space under the bitmap that will be drawn
    matrix->drawBitmap(xref, yref, small_font[bmp_num], 3, 5, color);
    matrix->show();
}

void display_5x3_integer(int number, int color){   // Handles display of numbers made of up to 2 5x3 symbols
  int tenth=0,unit=0;
  matrix->fillRect(0,0, 8,8, LED_BLACK);
  tenth=number/10;
  unit=number%10;
  if (tenth>0){
    display_5x3_font(tenth, color,1,1);
    display_5x3_font(unit, color,5,1);
  }
  else {
    display_5x3_font(unit, color,2,1);
  }
}

void display_scrolling_text(String message, int16_t rotation,int16_t text_color, int16_t y_pos){
    //matrix->clear();
    matrix->setTextWrap(false);  // we don't wrap text so it scrolls nicely
    matrix->setTextSize(1);
    matrix->setRotation(rotation);
    matrix->setTextColor(text_color);
    int16_t message_length=message.length();
    int16_t font_width;
    #if USE_5X3_FONT
      font_width=4;
    #else
      font_width=5;
    #endif

    for (int16_t x=7; x>=-font_width*message_length; x--) {
       matrix->clear();
       matrix->setCursor(x,y_pos);
       matrix->print(message);
       matrix->show();
       delay(100);  // This delay sets the speed of scrolling text
    }
    matrix->fillRect(0,0, 8,8, LED_BLACK);   // Matrix is black after text has scrolled completely
}

long readVcc(){
  // Read 1.1V reference against AVcc
  // set the reference to Vcc and the measurement to the internal 1.1V reference
  #if defined(__AVR_ATmega32U4__) || defined(__AVR_ATmega1280__) || defined(__AVR_ATmega2560__)
    ADMUX = _BV(REFS0) | _BV(MUX4) | _BV(MUX3) | _BV(MUX2) | _BV(MUX1);
  #elif defined (__AVR_ATtiny24__) || defined(__AVR_ATtiny44__) || defined(__AVR_ATtiny84__)
    ADMUX = _BV(MUX5) | _BV(MUX0);
  #elif defined (__AVR_ATtiny25__) || defined(__AVR_ATtiny45__) || defined(__AVR_ATtiny85__)
    ADMUX = _BV(MUX3) | _BV(MUX2);
  #else
    ADMUX = _BV(REFS0) | _BV(MUX3) | _BV(MUX2) | _BV(MUX1);
  #endif

  delay(2); // Wait for Vref to settle
  ADCSRA |= _BV(ADSC); // Start conversion
  while (bit_is_set(ADCSRA,ADSC)); // measuring

  uint8_t low  = ADCL; // must read ADCL first - it then locks ADCH
  uint8_t high = ADCH; // unlocks both

  long result = (high<<8) | low;

  result = 1125300L / result; // Calculate Vcc (in mV); 1125300 = 1.1*1023*1000
  return result; // Vcc in millivolts
}

void showBatteryState(uint16_t currentVCC){ // Use icons and colors to show battery state based on VCC value

  // Values used to set battery indicator
  #define LOW_VCC 2700  // lower vcc value when checking battery level
  #define ALARM_VCC 3000 // VCC level below which the red Battery alarm is shown
  #define HIGH_VCC 3200  // higher vcc value when checking battery level

  uint16_t batteryVCC[] = { LOW_VCC,ALARM_VCC,ALARM_VCC,HIGH_VCC,HIGH_VCC };  // Sequence of symbols from monochrome_8x8_symbols.h in battery level display
  uint16_t batterycolor[] = { LED_RED_MEDIUM, LED_ORANGE_MEDIUM,  LED_ORANGE_MEDIUM, LED_GREEN_MEDIUM,LED_GREEN_MEDIUM};  // Sequence of colors in battery level display
  uint16_t batterysymbol[] = { 0,1,2,3,4 };  // Sequence of symbols from monochrome_8x8_symbols.h in battery level display
  matrix->fillRect(0,0, 8,8, LED_BLACK);   // Matrix is black
  display_bitmap(batterysymbol[0], batterycolor[0]);
  delay(300);
  for (uint8_t i=0; i<5;i++){
    if (currentVCC>=batteryVCC[i]){
      matrix->fillRect(0,0, 8,8, LED_BLACK);   // Matrix is black
      display_bitmap(batterysymbol[i], batterycolor[i]);
      delay(100);
    }
  }
  delay (300);
  matrix->fillRect(0,0, 8,8, LED_BLACK);   // Matrix is black
  matrix->show();

  attractMode();
  
}

void pinInterrupt(void){  // Used to allow board wake up by button press
     detachInterrupt(0);
 }

void sleepNow(void){  // Routine to put board to sleep and control actions on waking-up
  Serial.println("Starting sleepNow");
    // Set pin 2 as interrupt and attach handler:
    attachInterrupt(0, pinInterrupt, LOW);
    delay(100);
    //
    set_sleep_mode(SLEEP_MODE_PWR_DOWN);
    //
    // Set sleep enable (SE) bit:
    sleep_enable();
    //
    // Put the device to sleep:
    matrix->fillRect(0,0, 8,8, LED_BLACK);  // Clear the matrix
    matrix->show();

    digitalWrite(MOSFET_PIN,LOW);   // turn LEDs off to indicate sleep
    digitalWrite(MPU_VCC, LOW);  // Turn off power supply to MPU
    Serial.println("Going to sleep... ");
    sleep_mode();
    //
    // Upon waking up, sketch continues from this point.
    
    sleep_disable();
    digitalWrite(MOSFET_PIN,HIGH);   // turn LED on to indicate awake
    digitalWrite(MPU_VCC, HIGH);  // Turn on power supply to MPU
    delay(100);

    Serial.println("Restarting... ");
    start_time=millis();
    
    while(checkButton() != CHOICE_NONE){delay(50);}  // Wait that button is released (used if returning from a button-induced wake-up)
    
    // Check battery state and print to serial
    Vcc=int(readVcc());
    Serial.print("VCC=");Serial.print(Vcc);Serial.println("mV");
    showBatteryState(Vcc);
}

void setLEDs(byte leds){  // Lights a given LEDs - Pass in a byte that is made up from CHOICE_RED, CHOICE_ORANGE, etc
  if ((leds & CHOICE_RED) != 0){
    matrix->fillTriangle(0,1, 0,5, 2,3,LED_RED_HIGH);
    matrix->fillTriangle(0,2, 0,6, 2,4,LED_RED_HIGH);
  }
  else {
    matrix->fillTriangle(0,1, 0,5, 2,3,LED_BLACK);
    matrix->fillTriangle(0,2, 0,6, 2,4,LED_BLACK);
  }
  if ((leds & CHOICE_GREEN) != 0){
    matrix->fillTriangle(1,0, 5,0, 3,2,LED_GREEN_HIGH);
    matrix->fillTriangle(2,0, 6,0, 4,2,LED_GREEN_HIGH);
  }
  else {
    matrix->fillTriangle(1,0, 5,0, 3,2,LED_BLACK);
    matrix->fillTriangle(2,0, 6,0, 4,2,LED_BLACK);
  }
  if ((leds & CHOICE_BLUE) != 0){
    matrix->fillTriangle(1,7, 5,7, 3,5,LED_BLUE_HIGH);
    matrix->fillTriangle(2,7, 6,7, 4,5,LED_BLUE_HIGH);
  }
  else {
    matrix->fillTriangle(1,7, 5,7, 3,5,LED_BLACK);
    matrix->fillTriangle(2,7, 6,7, 4,5,LED_BLACK);
  }
  if ((leds & CHOICE_ORANGE) != 0){
    matrix->fillTriangle(7,1, 7,5, 5,3,LED_ORANGE_HIGH);
    matrix->fillTriangle(7,2, 7,6, 5,4,LED_ORANGE_HIGH);
  }
  else {
    matrix->fillTriangle(7,1, 7,5, 5,3,LED_BLACK);
    matrix->fillTriangle(7,2, 7,6, 5,4,LED_BLACK);
  }
  matrix->show();
}

byte checkButton(void){  // Returns a '1' bit in the position corresponding to CHOICE_RED, CHOICE_GREEN, etc.
  CheckAccel();
  if (digitalRead(BUTTON_RED) == 0 || orientation == RED_RELEASED) return(CHOICE_RED);
  else if (digitalRead(BUTTON_GREEN) == 0 || orientation == GREEN_RELEASED) return(CHOICE_GREEN);
  else if (digitalRead(BUTTON_BLUE) == 0 || orientation == BLUE_RELEASED) return(CHOICE_BLUE);
  else if (digitalRead(BUTTON_ORANGE) == 0 || orientation == YELLOW_RELEASED) return(CHOICE_ORANGE);

  return(CHOICE_NONE); // If no button is pressed, return none
}

void buzz_sound(int buzz_length_ms, int buzz_delay_us){  // Toggle buzzer every buzz_delay_us, for a duration of buzz_length_ms.
  // Convert total play time from milliseconds to microseconds
  long buzz_length_us = buzz_length_ms * (long)1000;

  // Loop until the remaining play time is less than a single buzz_delay_us
  while (buzz_length_us > (buzz_delay_us * 2))
  {
    buzz_length_us -= buzz_delay_us * 2; //Decrease the remaining play time

    // Toggle the buzzer at various speeds
    digitalWrite(BUZZER1, LOW);
    delayMicroseconds(buzz_delay_us);


    digitalWrite(BUZZER1, HIGH);
    delayMicroseconds(buzz_delay_us);
  }
  digitalWrite(BUZZER1, LOW);  // Always power down piezo when sound is finished
}

void toner(byte which, int buzz_length_ms){
  // Light an LED and play tone
  // Red, upper left:     440Hz - 2.272ms - 1.136ms pulse
  // Green, upper right:  880Hz - 1.136ms - 0.568ms pulse
  // Blue, lower left:    587.33Hz - 1.702ms - 0.851ms pulse
  // ORANGE, lower right: 784Hz - 1.276ms - 0.638ms pulse
  setLEDs(which); //Turn on a given LED

  //Play the sound associated with the given LED
  switch(which)
  {
  case CHOICE_RED:
    buzz_sound(buzz_length_ms, 1136);
    break;
  case CHOICE_GREEN:
    buzz_sound(buzz_length_ms, 568);
    break;
  case CHOICE_BLUE:
    buzz_sound(buzz_length_ms, 851);
    break;
  case CHOICE_ORANGE:
    buzz_sound(buzz_length_ms, 638);
    break;
  }

  setLEDs(CHOICE_OFF); // Turn off all LEDs
}

byte wait_for_button(void){
  // Wait for a button to be pressed.
  // Returns one of LED colors (LED_RED, etc.) if successful, 0 if timed out
  long startTime = millis(); // Remember the time we started the this loop

  while ( (millis() - startTime) < ENTRY_TIME_LIMIT) // Loop until too much time has passed
  {
    byte button = checkButton();

    if (button != CHOICE_NONE)
    {
      toner(button, 150); // Play the button the user just pressed

      while(checkButton() != CHOICE_NONE) ;  // Now let's wait for user to release button

      delay(10); // This helps with debouncing and accidental double taps

      return button;
    }

  }

  return CHOICE_NONE; // If we get here, we've timed out!
}

void winner_sound(void){  // Play the winner sound. Toggle the buzzer at various speeds.
  for (byte x = 250 ; x > 70 ; x--)
  {
    for (byte y = 0 ; y < 3 ; y++)
    {
      digitalWrite(BUZZER1, LOW);
      delayMicroseconds(x);

      digitalWrite(BUZZER1, HIGH);
      delayMicroseconds(x);
    }
  }
  digitalWrite(BUZZER1, LOW);  // Always power down piezo when sound is finished
}

void play_winner(void){  // Play the winner sound and lights
  setLEDs(CHOICE_GREEN | CHOICE_BLUE);
  winner_sound();
  setLEDs(CHOICE_RED | CHOICE_ORANGE);
  winner_sound();
  setLEDs(CHOICE_GREEN | CHOICE_BLUE);
  winner_sound();
  setLEDs(CHOICE_RED | CHOICE_ORANGE);
  winner_sound();
}

void play_loser(void){  // Play the loser sound/lights
  setLEDs(CHOICE_RED | CHOICE_GREEN);
  buzz_sound(255, 1500);

  setLEDs(CHOICE_BLUE | CHOICE_ORANGE);
  buzz_sound(255, 1500);

  setLEDs(CHOICE_RED | CHOICE_GREEN);
  buzz_sound(255, 1500);

  setLEDs(CHOICE_BLUE | CHOICE_ORANGE);
  buzz_sound(255, 1500);

  start_time=millis();  // Reset counter before game goes to sleep mode
}

void RestMode(void){  // Turn off LEDs to save battery but dont cut LED power supply yet to avoid white flash if user returns before sleep. Send to sleep if wait time is too long.
  Serial.println("Starting RestMode");
  matrix->fillRect(0,0, 8,8, LED_BLACK);  // Clear the matrix
  matrix->show();
  while(1)
    {
    if (millis()-start_time>MAX_REST_TIME){sleepNow();}
    if (checkButton() != CHOICE_NONE){start_time=millis();return;}
  }
}

void attractMode(void){  // Show an "attract mode" display while waiting for user to press button. Send to sleep if wait time is too long.
  

  while(1){
    if ((millis()-start_time>MAX_IDLE_TIME)){start_time=millis();RestMode();}
      if (millis()-ref_time>=300){
        ref_time=millis();
        for (uint16_t i=0; i<4; i++){
          current_color=(current_color+3)%27;
          matrix->drawRect(i, i, 8-2*i, 8-2*i, morebmpcolor[current_color]);
        }
        matrix->show();
      }
      CheckAccel();
      if (checkButton() != CHOICE_NONE){
        return;
      }
  }
}

void test_tilt(void){
  while(1)
  {
    if (millis()-start_time>MAX_IDLE_TIME){start_time=millis();RestMode();}
    while(checkButton() != CHOICE_NONE){delay(50);}  // Wait that button is released (used if returning from a button-induced wake-up)
    CheckAccel();
    if(orientation!=previous_orientation){
      previous_orientation=orientation;
      if(position[orientation]=="RED_DOWN"){setLEDs(CHOICE_RED);}
      else if(position[orientation]=="BLUE_DOWN"){setLEDs(CHOICE_BLUE);}
      else if(position[orientation]=="YELLOW_DOWN"){setLEDs(CHOICE_ORANGE);}
      else if(position[orientation]=="GREEN_DOWN"){setLEDs(CHOICE_GREEN);}
      else if(position[orientation]=="POSITION_5"){setLEDs(CHOICE_NONE);} // Turn off LEDs
    }
    if (checkButton() != CHOICE_NONE) return;
  }
}

void playMoves(void){ // Plays the current contents of the game moves
  for (byte currentMove = 0 ; currentMove < gameRound ; currentMove++)
  {
    toner(gameBoard[currentMove], 150);

    // Wait some amount of time between button playback
    // Shorten this to make game harder
    delay(150); // 150 works well. 75 gets fast.
  }
}

void add_to_moves(void){ // Adds a new random button to the game sequence, by sampling the timer
  byte newButton = random(0, 4); //min (included), max (exluded)

  // We have to convert this number, 0 to 3, to CHOICEs
  if(newButton == 0) newButton = CHOICE_RED;
  else if(newButton == 1) newButton = CHOICE_GREEN;
  else if(newButton == 2) newButton = CHOICE_BLUE;
  else if(newButton == 3) newButton = CHOICE_ORANGE;

  gameBoard[gameRound++] = newButton; // Add this new button to the game array
}

//-=-=-=-=-=-=-=-=-=-=-=-=-=-=-=-=-=-=-=-=-=-=-=-=-=-=-=-=-=-=
//The following functions are related to game play only

boolean play_memory(void){ // Play the regular memory game
// Returns 0 if player loses, or 1 if player wins
  randomSeed(millis()); // Seed the random generator with random amount of millis()

  gameRound = 0; // Reset the game to the beginning

  while (gameRound < ROUNDS_TO_WIN)
  {
    add_to_moves(); // Add a button to the current moves, then play them back

    playMoves(); // Play back the current game board

    // Then require the player to repeat the sequence.
    for (byte currentMove = 0 ; currentMove < gameRound ; currentMove++)
    {
      byte choice = wait_for_button(); // See what button the user presses

      if (choice == 0) return false; // If wait timed out, player loses

      if (choice != gameBoard[currentMove]) return false; // If the choice is incorect, player loses
    }

    delay(1000); // Player was correct, delay before playing moves
  }

  return true; // Player made it through all the rounds to win!
}

boolean play_battle(void){ // Play the special 2 player battle mode
// A player begins by pressing a button then handing it to the other player
// That player repeats the button and adds one, then passes back.
// This function returns when someone loses
  gameRound = 0; // Reset the game frame back to one frame

  while (1) // Loop until someone fails
  {
    byte newButton = wait_for_button(); // Wait for user to input next move
    gameBoard[gameRound++] = newButton; // Add this new button to the game array

    // Then require the player to repeat the sequence.
    for (byte currentMove = 0 ; currentMove < gameRound ; currentMove++)
    {
      byte choice = wait_for_button();

      if (choice == 0) return false; // If wait timed out, player loses.

      if (choice != gameBoard[currentMove]) return false; // If the choice is incorect, player loses.
    }

    delay(100); // Give the user an extra 100ms to hand the game to the other player
  }

  return true; // We should never get here
}

//-=-=-=-=-=-=-=-=-=-=-=-=-=-=-=-=-=-=-=-=-=-=-=-=-=-=-=-=-=-=
// The following functions are related to Beegees Easter Egg only

int melody[] = {  // Notes in the melody. Each note is about an 1/8th note, "0"s are rests.
  NOTE_G4, NOTE_A4, 0, NOTE_C5, 0, 0, NOTE_G4, 0, 0, 0,
  NOTE_E4, 0, NOTE_D4, NOTE_E4, NOTE_G4, 0,
  NOTE_D4, NOTE_E4, 0, NOTE_G4, 0, 0,
  NOTE_D4, 0, NOTE_E4, 0, NOTE_G4, 0, NOTE_A4, 0, NOTE_C5, 0};
int noteDuration = 115; // This essentially sets the tempo, 115 is just about right for a disco groove :)
int LEDnumber = 0; // Keeps track of which LED we are on during the beegees loop

void changeLED(void){  // Each time this function is called the board moves to the next LED
  setLEDs(1 << LEDnumber); // Change the LED

  LEDnumber++; // Goto the next LED
  if(LEDnumber > 3) LEDnumber = 0; // Wrap the counter if needed
}

void play_beegees(){  // Do nothing but play bad beegees music. This function is activated when user holds bottom right button during power up.
  //Turn on the bottom right (ORANGE) LED
  setLEDs(CHOICE_ORANGE);
  toner(CHOICE_ORANGE, 150);

  setLEDs(CHOICE_RED | CHOICE_GREEN | CHOICE_BLUE); // Turn on the other LEDs until you release button

  while(checkButton() != CHOICE_NONE) ; // Wait for user to stop pressing button

  setLEDs(CHOICE_NONE); // Turn off LEDs

  delay(1000); // Wait a second before playing song

  //digitalWrite(BUZZER1, LOW); // setup the "BUZZER1" side of the buzzer to stay low, while we play the tone on the other pin.

  while(checkButton() == CHOICE_NONE) //Play song until you press a button
  {
    // iterate over the notes of the melody:
    for (int thisNote = 0; thisNote < 32; thisNote++) {
      changeLED();
      tone(BUZZER1, melody[thisNote],noteDuration);
      // to distinguish the notes, set a minimum time between them.
      // the note's duration + 30% seems to work well:
      int pauseBetweenNotes = noteDuration * 1.30;
      delay(pauseBetweenNotes);
      // stop the tone playing:
      noTone(BUZZER1);
    }
  }
}

void setup(){
  Serial.begin(115200);  // Establish serial connection for debugging

  //Setup hardware inputs/outputs. These pins are defined in the hardware_versions header file

  //Enable pull ups on inputs to save on resistors!
  pinMode(BUTTON_RED, INPUT_PULLUP);
  pinMode(BUTTON_GREEN, INPUT_PULLUP);
  pinMode(BUTTON_BLUE, INPUT_PULLUP);
  pinMode(BUTTON_ORANGE, INPUT_PULLUP);

  pinMode(BUILT_IN_LED, OUTPUT);
  digitalWrite(BUILT_IN_LED, LOW);  // Turn off LED matrix 5V supply

  pinMode(MOSFET_PIN, OUTPUT);
  digitalWrite(MOSFET_PIN, HIGH);  // Turn on LED matrix 5V supply

  pinMode(MPU_VCC, OUTPUT);
  digitalWrite(MPU_VCC, HIGH);  // Turn on power supply to MPU

  //Setup outputs for buzzer
  pinMode(BUZZER1, OUTPUT);

  // MPU
  Wire.begin();
  delay(500);
  accelgyro.initialize();
  Serial.println("Starting MPU... ");

  // Initialize LED matrix
  matrix->setRotation(matrix_set_rotation[0]);   // Rotate display accordinly 0, 1, 2 or 3
  matrix->begin();
  matrix->setTextWrap(false);
  matrix->setBrightness(BRIGHTNESS);

  #if USE_5X3_FONT
    matrix->setFont(&small_5x34pt7b);  // Change from default 7pts font to custom 5x3 font
    y_text_ref =6;
  # endif

  # if SHOW_SPLASH_SCREEN
  display_scrolling_text("GeaiRareDit    ", 2,LED_GREEN_MEDIUM,y_text_ref);
  matrix->fillRect(0,0, 8,8, LED_BLACK);
  matrix->show();
  # endif

  matrix->clear();
  //winner_sound();
  delay(1000);

  // Check battery state and print to serial
  Vcc=int(readVcc());
  Serial.print("VCC=");Serial.print(Vcc);Serial.println("mV");
  showBatteryState(Vcc);

  CalibrateAccel();

//debug
  CheckAccel();

  

  gameRecord = word(EEPROM.read(1), EEPROM.read(2));  // Reading Door_opening_counter from EEPROM. Is stored in two variables to allow interger size.
  Serial.print("Value stored in EEPROM - As read in Setup routine: "); Serial.println(gameRecord);  

  Serial.print("As a binary: ");
  for (int i = 15; i >=0; i--){
    Serial.print(BIT(gameRecord,i));
  }
  Serial.println("");

  
  /*
    // If gameRecord counter needs to be resetted
    gameRecord=0;
    EEPROM.write(1, highByte(gameRecord ));
    EEPROM.write(2, lowByte(gameRecord ));
    Serial.print("Value in EEPROM has been resetted to ");Serial.println(gameRecord);
    Serial.println("***************************************************");
  */
  
  //Mode checking
  gameMode = MODE_MEMORY; // By default, we're going to play the memory game

  // Check to see if the lower right button is pressed
  if (checkButton() == CHOICE_ORANGE) play_beegees();

  // Check to see if upper right button is pressed
  if (checkButton() == CHOICE_GREEN)
  {
    gameMode = MODE_BATTLE; //Put game into battle mode

    //Turn on the upper right (green) LED
    setLEDs(CHOICE_GREEN);
    toner(CHOICE_GREEN, 150);

    setLEDs(CHOICE_RED | CHOICE_BLUE | CHOICE_ORANGE); // Turn on the other LEDs until you release button

    while(checkButton() != CHOICE_NONE) ; // Wait for user to stop pressing button

    //Now do nothing. Battle mode will be serviced in the main routine
  }

  

  //for (int i=0; i<15;i++){display_5x3_integer(i); delay(2000);}
}

void loop(){
  attractMode(); // Blink lights while waiting for user to press a button
  
  //test_tilt();  // Debug routine to check accel readings
  //display_bitmap(5, bmpcolor[2]);
  
  // Indicate the start of game play
  matrix->fillRect(0,0, 8,8, LED_BLACK);  // Clear the matrix
  matrix->show();
  play_winner(); // Indicate the start of game 
  matrix->fillRect(0,0, 8,8, LED_BLACK);  // Clear the matrix
  matrix->show();
  //setLEDs(CHOICE_RED | CHOICE_GREEN | CHOICE_BLUE | CHOICE_ORANGE); // Turn all LEDs on
  delay(1000);
  
  CheckAccel();
  //Serial.println(condition);

  if (checkButton() == CHOICE_ORANGE) play_beegees();

  if (checkButton() == CHOICE_GREEN)
  {
    gameMode = MODE_BATTLE; //Put game into battle mode

    //Turn on the upper right (green) LED

    matrix->fillRect(0,0, 8,8, LED_PURPLE_MEDIUM);
    matrix->show();

    toner(CHOICE_GREEN, 150);
    delay(1000);
    //matrix->fillRect(0,0, 8,8, LED_BLACK);

    setLEDs(CHOICE_RED | CHOICE_BLUE | CHOICE_ORANGE); // Turn on the other LEDs until you release button

    while(checkButton() != CHOICE_NONE) ; // Wait for user to stop pressing button

    //Now do nothing. Battle mode will be serviced in the main routine
  }
  else {gameMode = MODE_MEMORY;}

  if (gameMode == MODE_MEMORY)
  {
    matrix->fillRect(0,0, 8,8, LED_BLACK);
    // Play memory game and handle result
    if (play_memory() == true)
      play_winner(); // Player won, play winner tones
    else
      play_loser(); // Player lost, play loser tones
      for (int i=0; i<4; i++){
        matrix->fillRect(0,0, 8,8, LED_BLACK);  // Clear the matrix
        //matrix->setRotation(matrix_set_rotation[orientation]);   // Rotate display accordinly 0, 1, 2 or 3
        matrix->setRotation(i);   // Rotate display accordinly 0, 1, 2 or 3
        display_5x3_integer(gameRound-1,LED_RED_MEDIUM); // Show number of rounds completed successfully
        delay(1000);
      }
      
      matrix->setRotation(matrix_set_rotation[0]);   // Rotate display accordinly 0, 1, 2 or 3
      matrix->fillRect(0,0, 8,8, LED_BLACK);  // Clear the matrix
      matrix->show();
      delay(200);

      if(gameRound-1>gameRecord){
        gameRecord=gameRound-1;
        Serial.print("gameRecord now updated to: ");Serial.println(gameRecord);
        EEPROM.write(1, highByte(gameRecord ));
        EEPROM.write(2, lowByte(gameRecord ));
      }
      
      //display_scrolling_text("Record: ", 2,LED_PURPLE_HIGH,5);
      
      for (int i=0; i<4; i++){
        matrix->fillRect(0,0, 8,8, LED_BLACK);  // Clear the matrix
        //matrix->setRotation(matrix_set_rotation[i]);   // Rotate display accordinly 0, 1, 2 or 3
        matrix->setRotation(i);   // Rotate display accordinly 0, 1, 2 or 3
        display_5x3_integer(gameRecord,LED_PURPLE_HIGH); // Show number of rounds completed successfully
        delay(1000);
      }
      matrix->setRotation(matrix_set_rotation[0]);   // Rotate display accordinly 0, 1, 2 or 3
      matrix->fillRect(0,0, 8,8, LED_BLACK);   // Matrix is black after text has scrolled completely
      matrix->show();
  }

  if (gameMode == MODE_BATTLE)
  {
    play_battle(); // Play game until someone loses

    play_loser(); // Player lost, play loser tones
  }

  start_time=millis();  // for debugging
  
}
