pepelepoisson/geairaredit/Code/ArduinoIDE/GeaiRareDit_R1_0/small_font_5x3-4pts.h

const uint8_t small_5x34pt7bBitmaps[] PROGMEM = {
  0xE8, 0xB4, 0xBE, 0xFA, 0xFB, 0xBE, 0x85, 0x42, 0x5E, 0x74, 0xC0, 0x6A,
  0x40, 0x95, 0x80, 0x55, 0x00, 0x5D, 0x00, 0x70, 0xE0, 0x80, 0x2A, 0x00,
  0xF6, 0xDE, 0xC9, 0x2E, 0xE7, 0xCE, 0xE7, 0x9E, 0xB7, 0x92, 0xF3, 0x9E,
  0xF3, 0xDE, 0xE4, 0x92, 0xF7, 0xDE, 0xF7, 0x9E, 0xA0, 0x47, 0x2A, 0x22,
  0xE3, 0x80, 0x88, 0xA8, 0xE5, 0x84, 0xF6, 0xCE, 0xF7, 0xDA, 0xF7, 0x5E,
  0xF2, 0x4E, 0xD6, 0xDC, 0xF3, 0xCE, 0xF3, 0xC8, 0xF2, 0xDE, 0xB7, 0xDA,
  0xE9, 0x2E, 0x24, 0xDE, 0xB7, 0x5A, 0x92, 0x4E, 0xFD, 0x6B, 0x5A, 0x80,
  0xF6, 0xDA, 0xF6, 0xDE, 0xF7, 0xC8, 0xF6, 0xDE, 0x80, 0xF7, 0x5A, 0xF3,
  0x9E, 0xE9, 0x24, 0xB6, 0xDE, 0xB6, 0xD4, 0xAD, 0x6B, 0x5F, 0x80, 0xB5,
  0x5A, 0xB7, 0xA4, 0xE5, 0x4E, 0xEA, 0xC0, 0x88, 0x80, 0xD5, 0xC0, 0x54,
  0xE0, 0x90, 0x76, 0xB0, 0x9A, 0xDC, 0xF2, 0x70, 0x2E, 0xD6, 0x57, 0x30,
  0x6B, 0xA4, 0xF7, 0x9C, 0x9A, 0xDA, 0xB8, 0x45, 0x60, 0x97, 0x5A, 0xD5,
  0x40, 0xFD, 0x6B, 0x50, 0xF6, 0xD0, 0xF6, 0xF0, 0xD6, 0xE8, 0x76, 0xB2,
  0xF6, 0x40, 0x70, 0xE0, 0x5D, 0x26, 0xB6, 0xF0, 0xB6, 0xA0, 0xAD, 0x6B,
  0xF0, 0xAA, 0xD0, 0xB7, 0x9C, 0xE6, 0x70, 0x6B, 0x26, 0xF8, 0xC9, 0xAC,
  0x5A };

const GFXglyph small_5x34pt7bGlyphs[] PROGMEM = {
  {     0,   0,   0,   4,    0,    1 },   // 0x20 ' '
  {     0,   1,   5,   2,    0,   -4 },   // 0x21 '!'
  {     1,   3,   2,   4,    0,   -4 },   // 0x22 '"'
  {     2,   3,   5,   4,    0,   -4 },   // 0x23 '#'
  {     4,   3,   5,   4,    0,   -4 },   // 0x24 '$'
  {     6,   3,   5,   4,    0,   -4 },   // 0x25 '%'
  {     8,   3,   5,   4,    0,   -4 },   // 0x26 '&'
  {    10,   1,   2,   2,    0,   -4 },   // 0x27 '''
  {    11,   2,   5,   3,    0,   -4 },   // 0x28 '('
  {    13,   2,   5,   3,    0,   -4 },   // 0x29 ')'
  {    15,   3,   3,   4,    0,   -3 },   // 0x2A '*'
  {    17,   3,   3,   4,    0,   -3 },   // 0x2B '+'
  {    19,   2,   2,   3,    0,   -1 },   // 0x2C ','
  {    20,   3,   1,   4,    0,   -2 },   // 0x2D '-'
  {    21,   1,   1,   2,    0,    0 },   // 0x2E '.'
  {    22,   3,   3,   4,    0,   -3 },   // 0x2F '/'
  {    24,   3,   5,   4,    0,   -4 },   // 0x30 '0'
  {    26,   3,   5,   4,    0,   -4 },   // 0x31 '1'
  {    28,   3,   5,   4,    0,   -4 },   // 0x32 '2'
  {    30,   3,   5,   4,    0,   -4 },   // 0x33 '3'
  {    32,   3,   5,   4,    0,   -4 },   // 0x34 '4'
  {    34,   3,   5,   4,    0,   -4 },   // 0x35 '5'
  {    36,   3,   5,   4,    0,   -4 },   // 0x36 '6'
  {    38,   3,   5,   4,    0,   -4 },   // 0x37 '7'
  {    40,   3,   5,   4,    0,   -4 },   // 0x38 '8'
  {    42,   3,   5,   4,    0,   -4 },   // 0x39 '9'
  {    44,   1,   3,   2,    0,   -3 },   // 0x3A ':'
  {    45,   2,   4,   3,    0,   -3 },   // 0x3B ';'
  {    46,   3,   5,   4,    0,   -4 },   // 0x3C '<'
  {    48,   3,   3,   4,    0,   -3 },   // 0x3D '='
  {    50,   3,   5,   4,    0,   -4 },   // 0x3E '>'
  {    52,   3,   5,   4,    0,   -4 },   // 0x3F '?'
  {    54,   3,   5,   4,    0,   -4 },   // 0x40 '@'
  {    56,   3,   5,   4,    0,   -4 },   // 0x41 'A'
  {    58,   3,   5,   4,    0,   -4 },   // 0x42 'B'
  {    60,   3,   5,   4,    0,   -4 },   // 0x43 'C'
  {    62,   3,   5,   4,    0,   -4 },   // 0x44 'D'
  {    64,   3,   5,   4,    0,   -4 },   // 0x45 'E'
  {    66,   3,   5,   4,    0,   -4 },   // 0x46 'F'
  {    68,   3,   5,   4,    0,   -4 },   // 0x47 'G'
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

const GFXfont small_5x34pt7b PROGMEM = {
  (uint8_t  *)small_5x34pt7bBitmaps,
  (GFXglyph *)small_5x34pt7bGlyphs,
  0x20, 0x7E, 7 };

// Approx. 853 bytes
