pepelepoisson/geairaredit/(commit log)

2020-01-23 Added first version of PCB and CAD designs
    [GeaiRareDit_CAD_V4.FCStd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]
2020-12-04 Added several packaging CAD versions and first code configured for Arduino IDE rather than ATOM PlatformIO due to compilation issues
    [Bague_montage_boutons.FCStd, Bague_montage_boutons.stl, Boitier_Proto_GeaiRareDit_V3.stl, Contour_PLA_V1.stl, Contour_PLA_V2.stl, DEssous_prototype_V1.stl, DEssous_prototype_V2.stl, Dessous_prototype.FCStd]
2020-12-10 Completed CAD V4 - Corresponds @99% to first 3 units made
    [Contour_PLA_V3.stl, GeaiRareDit_CAD_V5.FCStd, GeaiRareDit_CAD_V6.FCStd, Porte_batterie_dessous_V2.stl, Porte_batterie_dessus_V2.stl, Rondelle_support_PCB_V3.stl]
2020-12-16 Cleanup after R1.0 release
    [Exploded_view.fcstd, GeaiRareDit_CAD_V5.FCStd, GeaiRareDit_CAD_V6.FCStd, Protecteur_transport_V1.stl]
